patrikeder/SAdiy/zynq-ebaz/rtl/sim/vectors/README.md

# Golden vectors

Generated by `zynq-ebaz/rtl/sim/gen_vectors.py` (run `rtl/scripts/gen.sh`; never edit by hand). Plain text for
`$readmemh`: one hex value per line, fixed width, upper case, no `0x`. `gen_vectors.py --check` (and the pytest
`rtl/tests/test_gen_vectors.py`) fail when these files are not current.

| File | Lines | Width | Content |
|---|---|---|---|
| `spi_words.hex` | 101 | 8 digits | ADF4351 register words, `Adf4351.registers()` (write order R5..R0, all six) for 16 points 30..480 MHz (high-side LO, IF 10.7 MHz, PFD 25 MHz), main output on at -4 dBm; then the corner words `00000000`, `FFFFFFFF`, `AAAAAAAA`, `55555555`, `80000001` |
| `spi_words.cnt` | 1 | 8 digits | number of words in `spi_words.hex` |
| `mbb_high.hex` | 4096 | 5 digits | `{old[5:0], new[5:0], make[5:0]}` (18 bit), index `old*64+new`, PIN LEVEL masks (bit i = line i), PE4302 active high. `make` is the pin state the real `PE4302` driver shows after its turning-on writes and before its turning-off writes. Rule: `make = old | new` |
| `mbb_low.hex` | 4096 | 5 digits | the same for active low (a low pin switches the stage in). Rule: `make = old & new` |
| `sweep_table.hex` | 38 | 16 digits | table of the scenario below, `{w1, w0}` (64 bit, `w0` the SPI word, `w1` the flags of rtl-spec.md section 5) |
| `sweep_spi.hex` | 38 | 8 digits | SPI words the engine must send, in order |
| `sweep_result.hex` | 24 | 8 digits | result words the engine must store, in order |
| `sweep_unlock.hex` | 24 | 1 digit | per result index: `1` = the testbench's lock model must time out for that point, `0` = lock |
| `sweep_meta.hex` | 6 | 8 digits | n_entries, n_results, n_avg, det_base, att_pins, number of SPI words |

Scenario of `sweep_*`: produced by `PlModel` with `DET_CFG.src = 1`, `DET_TEST.base = 0x0100`,
`N_AVG = 4`, all timing registers at their reset values, `stop_on_err = 0`, `PE4302.manual` at its reset
value, `pin_owner = 1`. Table from `build_table()` for 24 points 50..450 MHz (IF 10.7 MHz, high-side
LO), `att_pins = 0x15` on the first entry, main output on at -4 dBm. Lock fails (timeout, result
bit 31 set) for result indices 5, 17; every other point locks. A result sum is `N_AVG * ((base + (index & 255)) & 0xFFFF)`.
