patrikeder/SAdiy/hw/netlist.md

# Netlist

Generated by `tools/gen_diagrams.py` from the pin map in `src/sadiy/pinmap.py`. Do not edit by hand.

BBB = BeagleBone Black headers P8 and P9. RPi = 40-pin header (physical pin numbers). Verify every pin on your image.

## SBC to board signals

| Net | Board | Board pin | Direction | BBB | RPi | Notes |
|---|---|---|---|---|---|---|
| SYN_CLK | ADF4351 | CLK | SBC to board | P9.22 SPI0_SCLK / GPIO0_2 | pin 23 GPIO11 / SPI0 SCLK | SPI mode 0, MSB first |
| SYN_DATA | ADF4351 | DAT | SBC to board | P9.18 SPI0_D1 (MOSI) / GPIO0_4 | pin 19 GPIO10 / SPI0 MOSI | 32-bit words |
| SYN_LE | ADF4351 | LE | SBC to board | P9.17 SPI0_CS0 / GPIO0_5 | pin 24 GPIO8 / SPI0 CE0 | SPI0 CS0, which is /dev/spidevN.0 (N = bus number, spi_device = 0); used as SPI chip select; data latches on the rising edge at the end of a transfer |
| SYN_LD | ADF4351 | LD | board to SBC | P9.23 GPIO1_17 | pin 35 GPIO19 / PCM_FS | digital lock detect output (Lock_Flag LED on the board), GPIO input; the MUX pin stays unused |
| SYN_CE | ADF4351 | CE | SBC to board | P9.27 GPIO3_19 | pin 36 GPIO16 | optional; tie the CE header pin to 3V3 until needed |
| ATT_V1 | PE4302 | V1 (0.5 dB) | SBC to board | P8.7 GPIO2_2 / TIMER4 | pin 29 GPIO5 | assumed weight; verify order and polarity with pe4302-walk |
| ATT_V2 | PE4302 | V2 (1 dB) | SBC to board | P8.8 GPIO2_3 / TIMER7 | pin 31 GPIO6 | assumed 1 dB stage |
| ATT_V3 | PE4302 | V3 (2 dB) | SBC to board | P8.9 GPIO2_5 / TIMER5 | pin 32 GPIO12 / PWM0 | assumed 2 dB stage |
| ATT_V4 | PE4302 | V4 (4 dB) | SBC to board | P8.10 GPIO2_4 / TIMER6 | pin 33 GPIO13 / PWM1 | assumed 4 dB stage |
| ATT_V5 | PE4302 | V5 (8 dB) | SBC to board | P8.11 GPIO1_13 / PRU0 R30_15 | pin 38 GPIO20 / PCM_DIN | assumed 8 dB stage |
| ATT_V6 | PE4302 | V6 (16 dB) | SBC to board | P8.12 GPIO1_12 / PRU0 R30_14 | pin 40 GPIO21 / PCM_DOUT | assumed 16 dB stage |
| DET_ADC | Detector | VOUT via divider | board to SBC | P9.39 AIN0 | n/a | BBB: AIN0 through the divider, a cross-check only (the ADS1115 is the main ADC); 0 to 1.8 V absolute maximum. RPi: ADS1115 only |
| ADC_GND | Detector | GND | return | P9.34 GNDA_ADC | n/a | optional, AIN0 cross-check only |
| I2C_SDA | ADS1115 | SDA | bidirectional | P9.20 I2C2_SDA / GPIO0_12 | pin 3 GPIO2 / SDA1 | main ADC on both platforms. BBB: I2C2 on the adapter board, which already has pull-ups (4.7k on the adapter not fitted) |
| I2C_SCL | ADS1115 | SCL | SBC to board | P9.19 I2C2_SCL / GPIO0_13 | pin 5 GPIO3 / SCL1 | main ADC on both platforms. BBB: I2C2 on the adapter board |

## Static straps on the boards (no SBC pin)

| Board | Pin | Tie to | Why |
|---|---|---|---|
| PE4302 | V1 ... V6 | module: 10k pull-downs | open inputs = 0 dB attenuation (the unsafe state). The adapter board's 2.2k pull-ups to 3V3 (R27..R32) give about 2.7 V at the pin, above the 2.3 V threshold, so the default is maximum attenuation; remove them for 0 dB |
| PE4302 | VDD pad | 3V3 (SBC pin) | the module has no regulator and is meant for 3.3 V (Silicon Chip). Two separate pads next to the chip, not on the 7-pin header (GND, V1 ... V6) |
| ADF4351 | DC jack | 5 V | on-board AMS1117-3.3 supplies the chip; check the polarity marking next to the jack. The 3V3 header pin is the regulator output: do not feed it |
| ADF4351 | CE | 3V3 | header pin, chip enable. Adapter board jumper J12: 1-2 tied high (default), 2-3 from the SBC pin (see SYN_CE) |
| ADF4351 | PDR | 3V3 | RF power-down pin (PDBRF): high = RF outputs on. Tied high on the adapter board (JP5); remove JP5 if the eval board already pulls it up |
| ADF4351 | AOUT- / AOUT+ | 50 ohm on the unused output | differential outputs, use one for the LO and terminate the other; MCLK is the external reference input (25 MHz oscillator fitted) |
| ADS1115 | A0 | detector VOUT via 1k, 100 nF, clamp | adapter board; no divider, the clamp holds A0 within 0 to 3.3 V |
| ADS1115 | ADDR | GND | I2C address 0x48 |
| ADS1115 | VDD | 3V3 (SBC pin) | 2.0 to 5.5 V |
| Detector | VCC pad | 5 V (verify) | about 68 mA at 5 V per the listing; the board has its own regulator (SOT-223), read its marking for the allowed input range |
| Detector | OUT header | check with a DMM | 2-pin header: find which pin is OUT and which is GND before connecting |

## Pins left free for later

- BBB: P9.11-P9.16, P8.13 to P8.19 and P8.26 (GPIO), SPI1 (P9.28-31), AIN1-AIN6, UART1 (P9.24/26).
- RPi: SPI0 CE1 (pin 26), GPIO 17/27/22/23/24/25, UART (pins 8/10).

## Ground and supply pins

- BBB: GND P9.1, P9.2, P9.43-46 and P8.1, P8.2; GNDA_ADC P9.34 (optional, AIN0 cross-check only); ADC reference VDD_ADC P9.32 (1.8 V, do not load).
- RPi: GND pins 6, 9, 14, 20, 25, 30, 34, 39.
- Board supplies come from the power tree, not from SBC pins (`power-tree.svg`).
