patrikeder/SAdiy/zynq-ebaz/docs/pinmap.md

# Pin map (generated by rtl/scripts/gen_pinmap.py, do not edit)

Reference: EBAZ4205 (XC7Z010-CLG400), expansion connectors DATA1..3 (2.0 mm, 2x10). All I/O LVCMOS33, series 22 ohm on the board. Master list: `rtl/vivado/pins.toml` (session L). "In use" = constrained in the current bitstream.

## Expansion connectors

| Connector pin | FPGA ball | Bank | I/O name | Signal | Dir | Function | Status | EMIO / note |
|---|---|---|---|---|---|---|---|---|
| DATA1-5 | A20 | 35 | IO_L2N_T0_AD8N_35 | `adc_d[0]` | in | AD9226 (planned) | planned |  |
| DATA1-6 | H16 | 35 | IO_L13P_T2_MRCC_35 | `adc_otr` | in | AD9226 (planned) | planned |  |
| DATA1-7 | B19 | 35 | IO_L2P_T0_AD8P_35 | `adc_d[1]` | in | AD9226 (planned) | planned |  |
| DATA1-8 | B20 | 35 | IO_L1N_T0_AD0N_35 | `adc_d[2]` | in | AD9226 (planned) | planned |  |
| DATA1-9 | C20 | 35 | IO_L1P_T0_AD0P_35 | `adc_d[3]` | in | AD9226 (planned) | planned |  |
| DATA1-11 | H17 | 35 | IO_L13N_T2_MRCC_35 | `adc_d[11]` | in | AD9226 (planned) | planned |  |
| DATA1-13 | D20 | 35 | IO_L4N_T0_35 | `adc_d[4]` | in | AD9226 (planned) | planned | schematic text says D19, see header |
| DATA1-14 | D18 | 35 | IO_L3N_T0_DQS_AD1N_35 | `adc_d[5]` | in | AD9226 (planned) | planned |  |
| DATA1-15 | H18 | 35 | IO_L14N_T2_AD4N_SRCC_35 | `adc_d[10]` | in | AD9226 (planned) | planned |  |
| DATA1-16 | D19 | 35 | IO_L4P_T0_35 | `adc_d[6]` | in | AD9226 (planned) | planned |  |
| DATA1-17 | F20 | 35 | IO_L15N_T2_DQS_AD12N_35 | `adc_d[7]` | in | AD9226 (planned) | planned |  |
| DATA1-18 | E19 | 35 | IO_L5N_T0_AD9N_35 | `adc_d[8]` | in | AD9226 (planned) | planned |  |
| DATA1-19 | F19 | 35 | IO_L15P_T2_DQS_AD12P_35 | `adc_d[9]` | in | AD9226 (planned) | planned |  |
| DATA1-20 | K17 | 35 | IO_L12P_T1_MRCC_35 | `adc_clk` | out | AD9226 (planned) | planned |  |
| DATA2-5 | G20 | 35 | IO_L18N_T2_AD13N_35 | `adf4351_clk` | out | ADF4351 synthesiser | in use | PS SPI0 SCLK via EMIO |
| DATA2-6 | J18 | 35 | IO_L14P_T2_AD4P_SRCC_35 | `spare_d2_6` | inout | spare | planned | spare |
| DATA2-7 | G19 | 35 | IO_L18P_T2_AD13P_35 | `adf4351_dat` | out | ADF4351 synthesiser | in use | PS SPI0 MOSI via EMIO |
| DATA2-8 | H20 | 35 | IO_L17N_T2_AD5N_35 | `adf4351_le` | out | ADF4351 synthesiser | in use | PS SPI0 SS0 via EMIO (LE = chip select) |
| DATA2-9 | J19 | 35 | IO_L10N_T1_AD11N_35 | `adf4351_ld` | in | ADF4351 synthesiser | in use | lock detect, EMIO GPIO input; pulldown so a missing cable reads unlocked |
| DATA2-11 | K18 | 35 | IO_L12N_T1_MRCC_35 | `i2c_sda` | inout | I2C, ADS1115 | in use | PS I2C0 SDA via EMIO |
| DATA2-13 | K19 | 35 | IO_L10P_T1_AD11P_35 | `adf4351_ce` | out | ADF4351 synthesiser | in use | EMIO GPIO, tri-stated until software drives it; adapter jumper holds CE high |
| DATA2-14 | J20 | 35 | IO_L17P_T2_AD5P_35 | `pe4302_v[0]` | out | PE4302 attenuator | in use | V1 = 0.5 dB |
| DATA2-15 | L16 | 35 | IO_L11P_T1_SRCC_35 | `pe4302_v[1]` | out | PE4302 attenuator | in use | V2 = 1 dB |
| DATA2-16 | L19 | 35 | IO_L9P_T1_DQS_AD3P_35 | `pe4302_v[2]` | out | PE4302 attenuator | in use | V3 = 2 dB |
| DATA2-17 | M18 | 35 | IO_L8N_T1_AD10N_35 | `pe4302_v[3]` | out | PE4302 attenuator | in use | V4 = 4 dB |
| DATA2-18 | L20 | 35 | IO_L9N_T1_DQS_AD3N_35 | `pe4302_v[4]` | out | PE4302 attenuator | in use | V5 = 8 dB |
| DATA2-19 | M20 | 35 | IO_L7N_T1_AD2N_35 | `pe4302_v[5]` | out | PE4302 attenuator | in use | V6 = 16 dB |
| DATA2-20 | L17 | 35 | IO_L11N_T1_SRCC_35 | `i2c_scl` | inout | I2C, ADS1115 | in use | PS I2C0 SCL via EMIO (ADS1115, address 0x48) |

Supply / ground per the plan: pins 1-2 of every connector are supply (5..12 V, never wire to a peripheral), 3-4 and 12 GND, 10 NC. DATA3 is not mapped yet.

## Board-fixed pins, one line each

| FPGA ball / pin | Bank | I/O name | Signal | Group |
|---|---|---|---|---|
| G17 | 35 | IO_L16P_T2_35 | `ENET0_GMII_RX_ER_0` | Ethernet PHY (MII on EMIO) |
| U14 | 34 | IO_L11P_T1_SRCC_34 | `ENET0_GMII_RX_CLK_0` | Ethernet PHY (MII on EMIO) |
| U15 | 34 | IO_L11N_T1_SRCC_34 | `ENET0_GMII_TX_CLK_0` | Ethernet PHY (MII on EMIO) |
| U18 | 34 | IO_L12P_T1_MRCC_34 | `enet0_phy_clk` | Ethernet PHY (MII on EMIO) |
| V16 | 34 | IO_L18P_T2_34 | `ENET0_GMII_RXD_P[1]` | Ethernet PHY (MII on EMIO) |
| V17 | 34 | IO_L21P_T3_DQS_34 | `ENET0_GMII_RXD_P[2]` | Ethernet PHY (MII on EMIO) |
| V18 | 34 | IO_L21N_T3_DQS_34 | `ENET0_GMII_TXD_P[2]` | Ethernet PHY (MII on EMIO) |
| W15 | 34 | IO_L10N_T1_34 | `enet0_mdio_mdc` | Ethernet PHY (MII on EMIO) |
| W16 | 34 | IO_L18N_T2_34 | `ENET0_GMII_RX_DV_0` | Ethernet PHY (MII on EMIO) |
| W18 | 34 | IO_L22P_T3_34 | `ENET0_GMII_TXD_P[0]` | Ethernet PHY (MII on EMIO) |
| W19 | 34 | IO_L22N_T3_34 | `ENET0_GMII_TX_EN_0[0]` | Ethernet PHY (MII on EMIO) |
| Y14 | 34 | IO_L8N_T1_34 | `enet0_mdio_mdio_io` | Ethernet PHY (MII on EMIO) |
| Y16 | 34 | IO_L7P_T1_34 | `ENET0_GMII_RXD_P[0]` | Ethernet PHY (MII on EMIO) |
| Y17 | 34 | IO_L7N_T1_34 | `ENET0_GMII_RXD_P[3]` | Ethernet PHY (MII on EMIO) |
| Y18 | 34 | IO_L17P_T2_34 | `ENET0_GMII_TXD_P[1]` | Ethernet PHY (MII on EMIO) |
| Y19 | 34 | IO_L17N_T2_34 | `ENET0_GMII_TXD_P[3]` | Ethernet PHY (MII on EMIO) |
| A16 | 501 | PS_MIO24_501 | MIO 24 | UART1 TX/RX (console, J7) |
| F15 | 501 | PS_MIO25_501 | MIO 25 | UART1 TX/RX (console, J7) |
| D14 | 501 | PS_MIO40_501 | MIO 40 | SD0 (boot card) |
| C17 | 501 | PS_MIO41_501 | MIO 41 | SD0 (boot card) |
| E12 | 501 | PS_MIO42_501 | MIO 42 | SD0 (boot card) |
| A9 | 501 | PS_MIO43_501 | MIO 43 | SD0 (boot card) |
| F13 | 501 | PS_MIO44_501 | MIO 44 | SD0 (boot card) |
| B15 | 501 | PS_MIO45_501 | MIO 45 | SD0 (boot card) |

Bank 34 and 35 are the PL I/O banks (3.3 V here); banks 500 and 501 are the PS MIO banks. Package ball map: `pinmap-fpga.svg`.

## EMIO line map (Linux GPIO line = 54 + n on the Zynq gpiochip)

| n | Signal | n | Signal |
|---|---|---|---|
| 0 | pe4302_v[0] (V1) | 8 | unused |
| 1 | pe4302_v[1] (V2) | 9 | unused |
| 2 | pe4302_v[2] (V3) | 10 | unused |
| 3 | pe4302_v[3] (V4) | 11 | unused |
| 4 | pe4302_v[4] (V5) | 12 | unused |
| 5 | pe4302_v[5] (V6) | 13 | unused |
| 6 | adf4351_ce | 14 | unused |
| 7 | adf4351_ld | 15 | unused |

Also on EMIO: SPI0 (SCLK, MOSI, SS0 = LE) and I2C0 (SCL, SDA), see the table above.
