patrikeder/SAdiy/hw/boards/ad831.md

# AD831 mixer board

| Item | Value |
|---|---|
| Part | AD831, doubly balanced active mixer |
| RF / LO bandwidth | to 500 MHz (RF IP3 spec'd to 400 MHz) |
| IF output | to 250 MHz differential current, or DC to over 200 MHz single-ended voltage |
| LO drive | -10 dBm |
| Performance | IP3 +24 dBm, P1dB +10 dBm, NF 10.3 dB @ 70 MHz, 14 dB @ 150 MHz |
| Supply (chip) | +/-4.5 to +/-5.5 V, or 9 to 11 V single; 100 to 125 mA |
| Common module | 33 x 33 mm, single 9 to 11 V supply, DC-isolation capacitors on RF / IF / LO, IF gain set by a resistor between OUT and VFB |

## Seen in the photo ([photos/ad831-module.jpg](../photos/ad831-module.jpg))
Silkscreen `AD831_MIX Freq:1-500MHz`. SMA `RFin` (one end), `LOin` (side), `IFout` (opposite end of RFin); two pads `GND` and `VCC` with grey leads soldered on. So it is the single-supply module (datasheet single supply: 9 to 11 V), not a bare chip. The supply voltage actually applied is not visible: measure it.

Fill in from the PCB
- Is this the common single-supply module or a custom board: TODO
- Supply connector, voltage actually used, measured current: TODO
- RF / LO / IF connectors (type, labels): TODO
- IF gain resistor value (OUT to VFB) and resulting conversion gain: TODO
- Which ports are AC-coupled, and the coupling capacitor values (low-frequency limit for the 10.7 MHz IF): TODO
- Test points available: TODO

The IF output needs a 10.7 MHz filter and gain before the detector (`../todo-parts.md`). LO should be about -10 dBm and low-pass filtered.
