patrikeder/SAdiy/hw/boards/adf4351.md

# ADF4351 synthesizer board (LO)

Photo: [photos/adf4351-board.jpg](../photos/adf4351-board.jpg). Silkscreen: `ADF4351X EVAL Board 2019_1_v1.4`.

## What the photo shows
- Reference: on-board oscillator marked `V25.000 KDSH 4D`, so the reference is **25 MHz**. An SMA `MCLK` input is next to it for an external reference.
- Outputs: two SMA connectors, `AOUT-` and `AOUT+` (the differential RF outputs). Both have cables fitted.
- Power: a DC barrel jack labelled **5 V** (with a polarity symbol and a red LED) and an `AMS1117 3.3` regulator on the board. The chip is supplied from the on-board 3.3 V.
- 2 x 5 pin header, left column `GND CE LE CLK LD`, right column `3V3 GND DAT MUX PDR` (rows from the top: GND/3V3, CE/GND, LE/DAT, CLK/MUX, LD/PDR).
- Silkscreen `Lock_Flag` next to an LED: lock detect indicator.

## Facts

| Item | Value |
|---|---|
| Part | ADF4351, 35 to 4400 MHz, 25 MHz PFD with this reference |
| Supply | 5 V on the DC jack; AMS1117-3.3 on the board. The `3V3` header pin is the regulator output: **do not feed it** |
| Logic | 3.3 V, SPI mode 0, MSB first, 32-bit words; `LE` latches on the rising edge |
| Header | `CLK`, `DAT`, `LE` = SPI; `LD` = lock detect output (use this); `MUX` = MUXOUT (unused); `CE` = chip enable; `PDR` = RF power-down pin (PDBRF), high = RF outputs on |
| RF output | -4 to +5 dBm in 3 dB steps; harmonics only 10 to 20 dB down (low-pass filter needed behind it) |

Use one output for the LO and terminate the other in 50 ohm (the outputs are complementary).

## RF outputs: off by default
- Software: both RF outputs are off after `Adf4351(...)` is constructed (it writes an R4 word with both disabled before anything else). An output is on only after `enable_output("main")` / `set_outputs(...)`, which should happen after the PLL is programmed and locked. `config/default.toml` enables only `out_main_enable`; a missing key means off.
- `AOUT+` and `AOUT-` are presumably the two halves of RFOUTA (the main output), so software cannot switch one of them off: whichever is not cabled to the mixer still needs the 50 ohm termination. The aux output (RFOUTB) is disabled in R4; check on the board schematic whether it is brought out at all.
- Hardware: the board's `PDR` pin (RF power-down) is currently to be tied high (see below). If the outputs should also stay off while the SBC is not running, drive `PDR` from an SBC pin with a pull-down instead. Not done, because it changes the adapter schematic and the wiring pages.

## Control from the SBC
- `CLK`, `DAT`, `LE` to the SPI0 pins (`../wiring-bbb.md`, `../wiring-rpi.md`), `LD` to a GPIO input, `GND` to the star point.
- `CE` and `PDR` must be high: tie them to the board's `3V3` pin, or keep CE on an SBC pin (`SYN_CE`). Measure first whether the board already pulls them up.
- The 25 MHz reference matches `synth.ref_hz` and `synth.pfd_hz` in `config/default.toml`.
- Driver: `src/sadiy/drivers/adf4351.py` (R4 with the output enables is done; R0..R3 and R5 packing still to be written).

## Still to check
- Polarity marking next to the DC jack before connecting the 5 V rail.
- Which SMA (`AOUT+` or `AOUT-`) is cabled to the mixer LO input and what the other one is terminated with.
- The loop filter on this board (affects lock time); measure the lock time before tightening `sweep.settle_s`.
- Current from 5 V (the linear regulator drops 1.7 V, so about 0.2 A of load is about 0.3 W of heat in the AMS1117).
