patrikeder/SAdiy/hw/boards/sbc.md

# SBC (BeagleBone Black preferred, Raspberry Pi 3/4/400 supported)

| Item | BBB | RPi |
|---|---|---|
| Supply | 5 V / 2 A | 5.1 V / 3 A (RPi 4 / 400) |
| GPIO / SPI level | 3.3 V | 3.3 V |
| Analog input | 8 channels, 12-bit, **0 to 1.8 V max** (verify on your image) | none: external ADC |
| Display | remote viewer over network | local monitor or remote |
| Image / OS version | TODO | TODO |
| python3 version | TODO (code supports 3.9+) | TODO |

Fill in
- Which board is actually used for the first build: TODO
- Header or breakout used to reach the boards: TODO
- Ground star point location: TODO

Pin map: `../wiring.md`. Setup notes: `../../deploy/bbb-setup.md`.
