patrikeder/SAdiy/hw/boards/sbc-adapter/placement.png

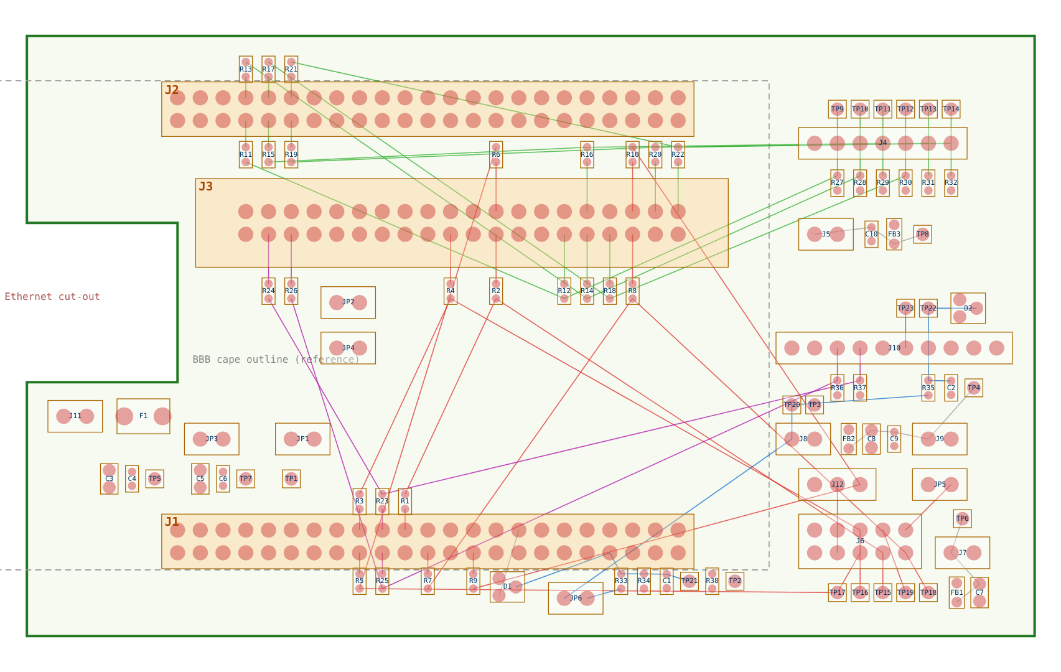
hw/boards/sbc-adapter/placement.png
