patrikeder/SAdiy/hw/boards/sbc-adapter/preview.png

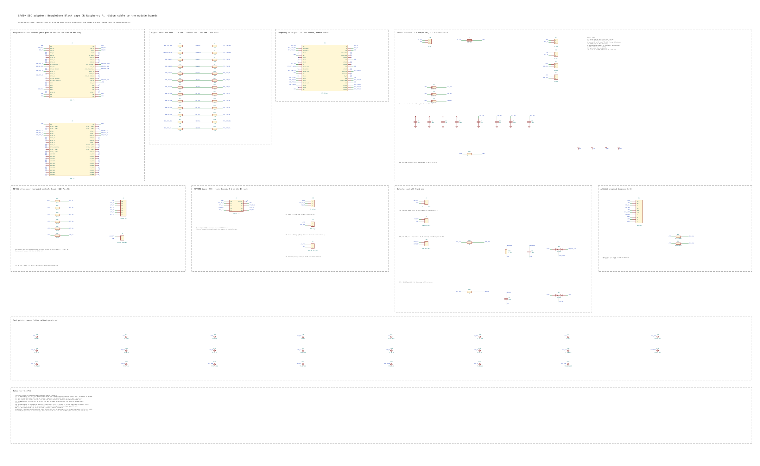
hw/boards/sbc-adapter/preview.png
