patrikeder/SAdiy/hw/boards/sbc-adapter/routability/heat.png

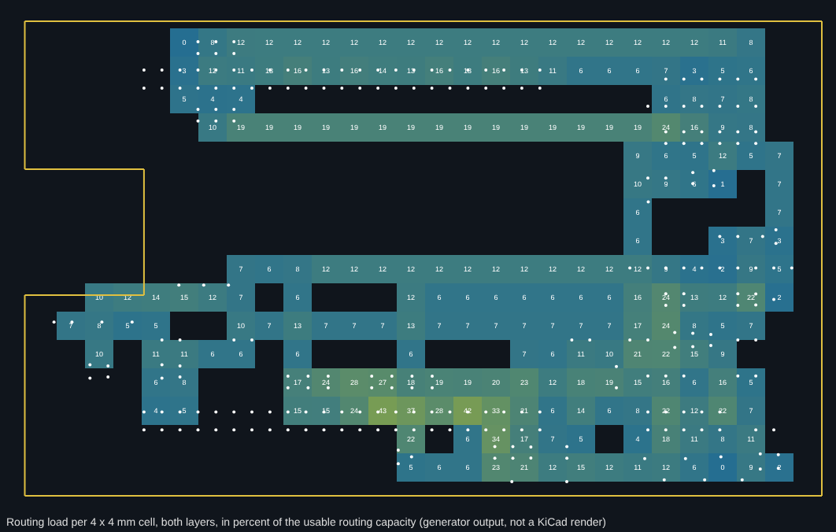
hw/boards/sbc-adapter/routability/heat.png
