patrikeder/SAdiy/hw/boards/sbc-adapter/routability/routed.png

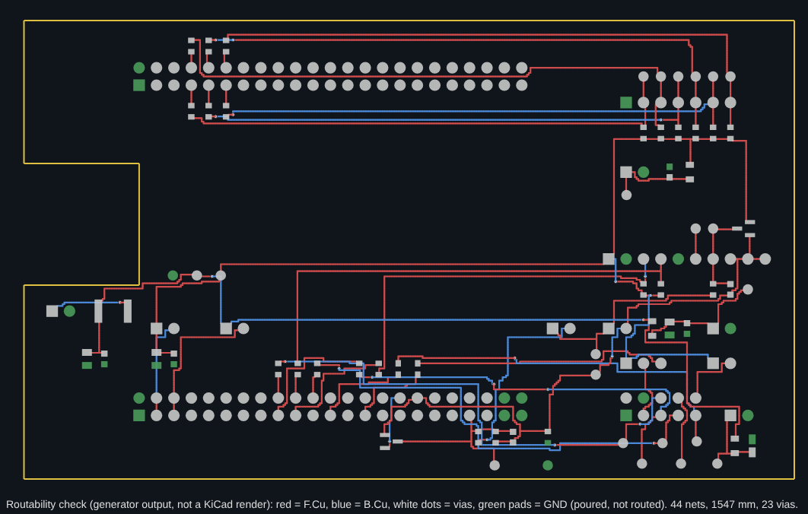
hw/boards/sbc-adapter/routability/routed.png
