patrikeder/SAdiy/hw/photos/ad831-module.jpg

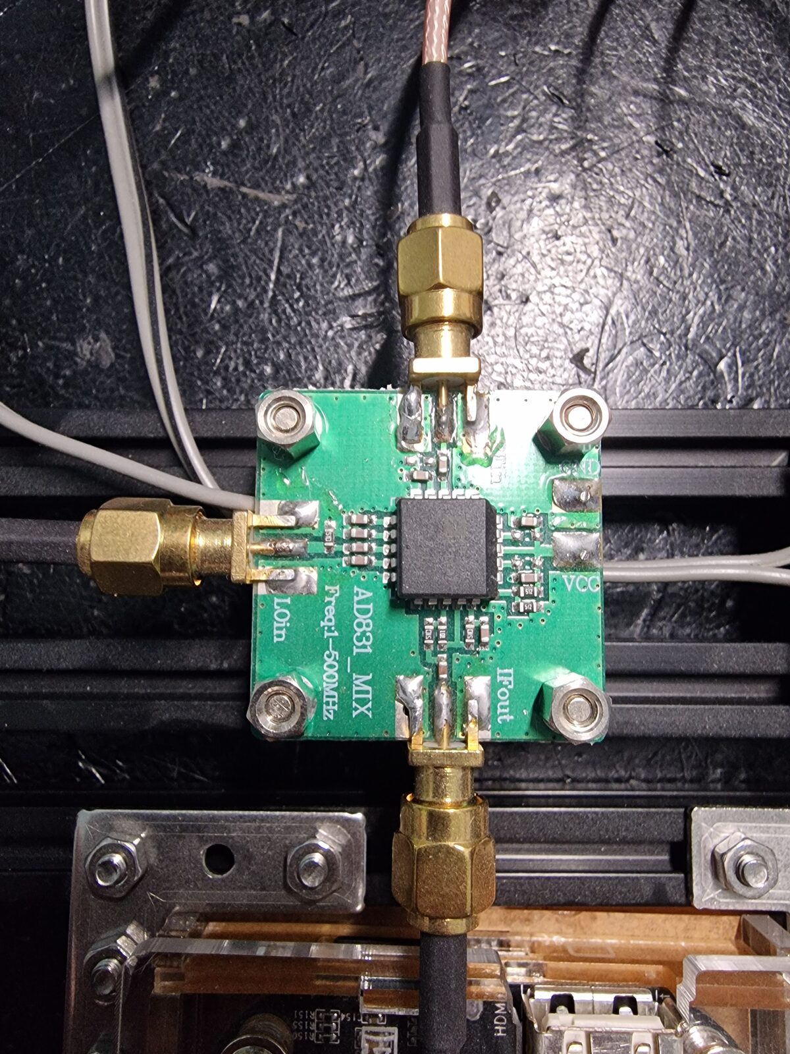
hw/photos/ad831-module.jpg
