patrikeder/SAdiy/hw/photos/adf4351-board.jpg

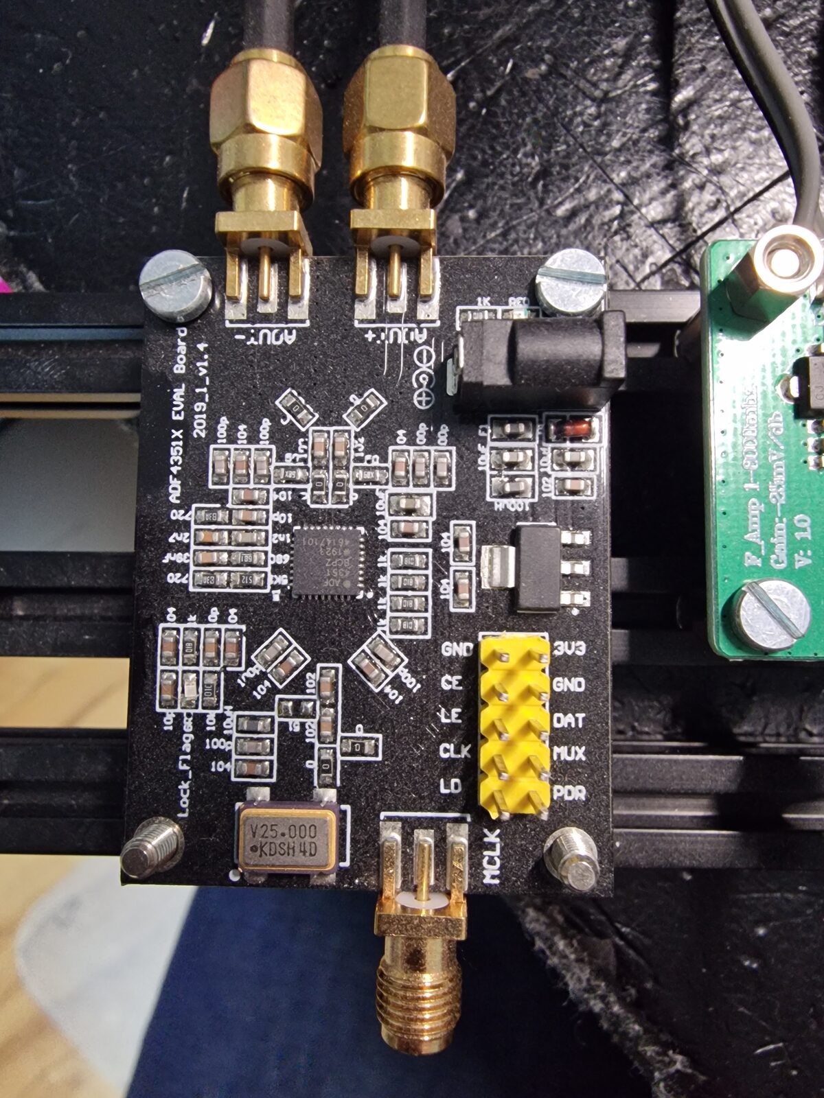
hw/photos/adf4351-board.jpg
