patrikeder/SAdiy/hw/photos/detector-module.jpg

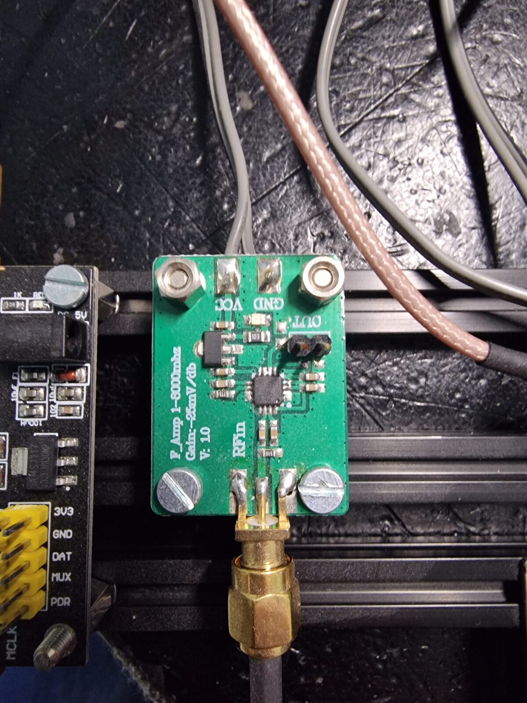
hw/photos/detector-module.jpg
