patrikeder/SAdiy/hw/photos/pe4302-module.jpg

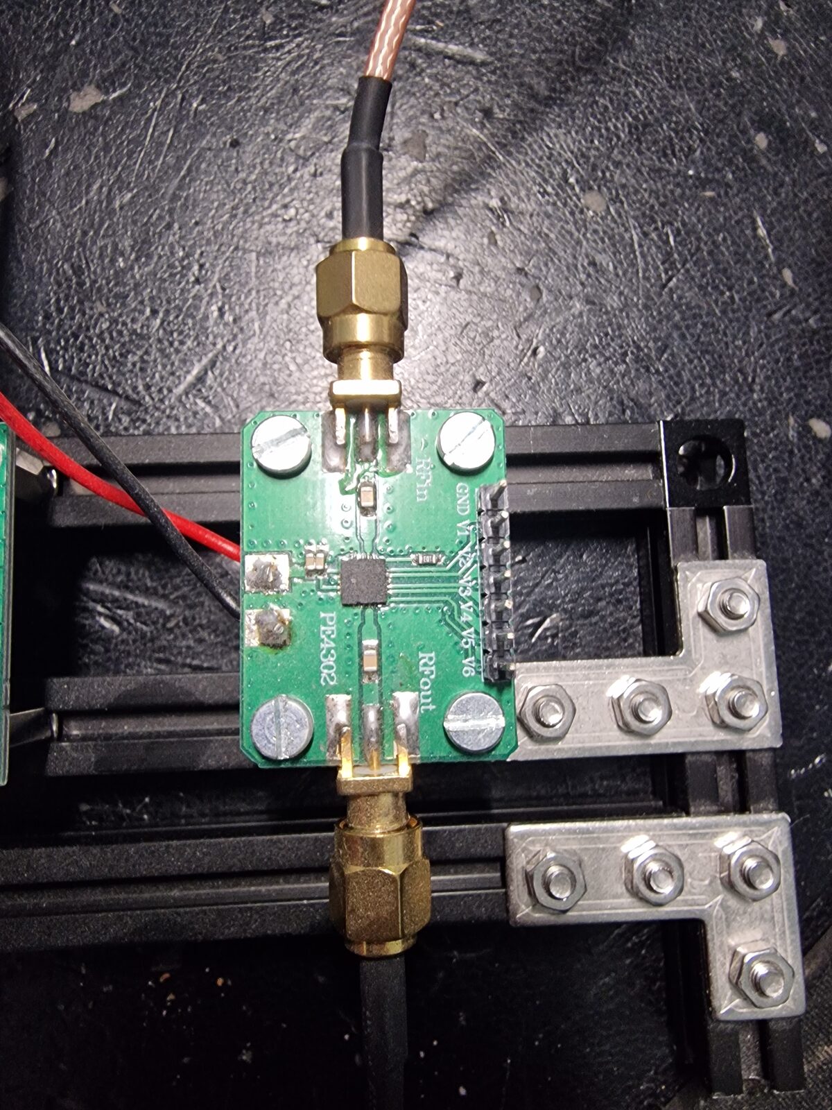
hw/photos/pe4302-module.jpg
