patrikeder/SAdiy/hw/boards/sbc-adapter/sa_sbc_adapter.kicad_pcb

## KiCad design hw/boards/sbc-adapter/sa_sbc_adapter.kicad_pcb (2026-11-05)

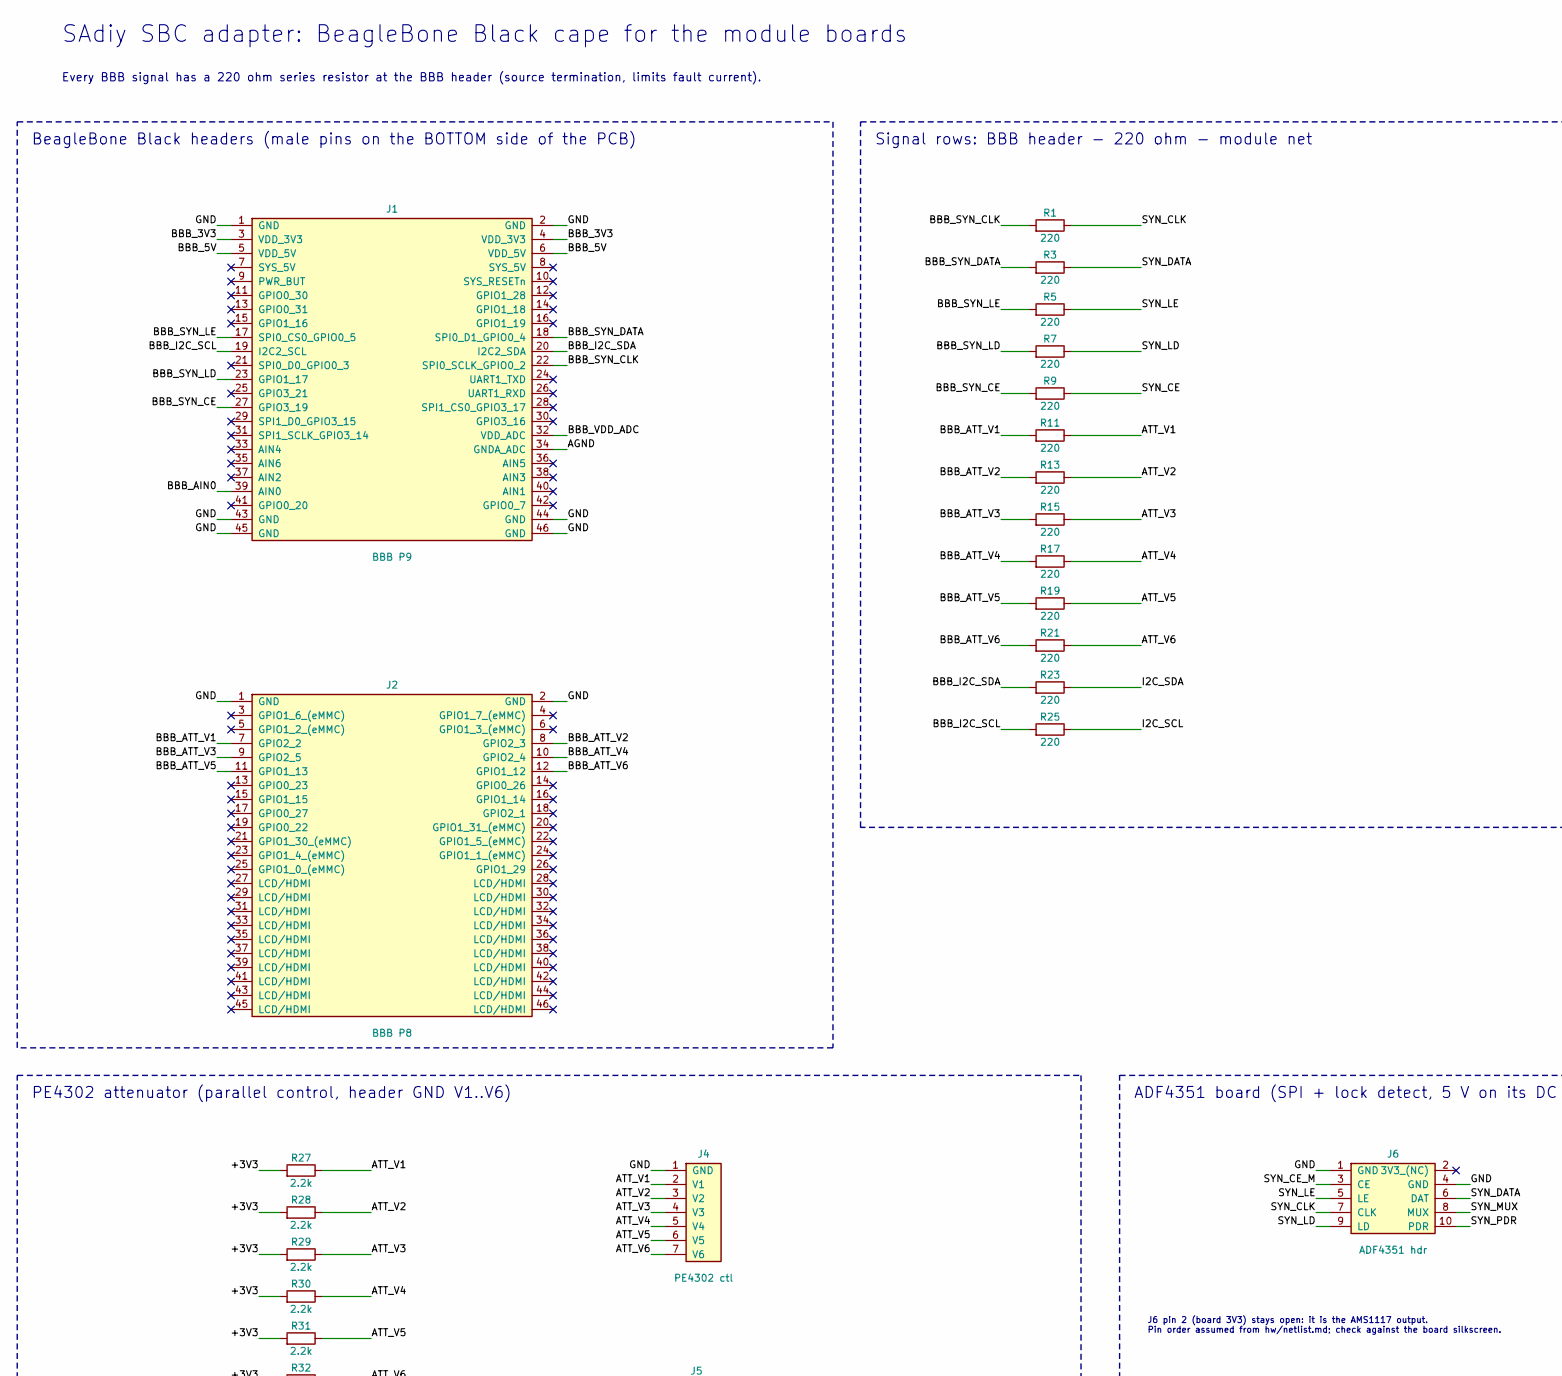
[picture p18: schematic sa_sbc_adapter.kicad_sch, SAdiy SBC adapter, part in row 1, column 1]

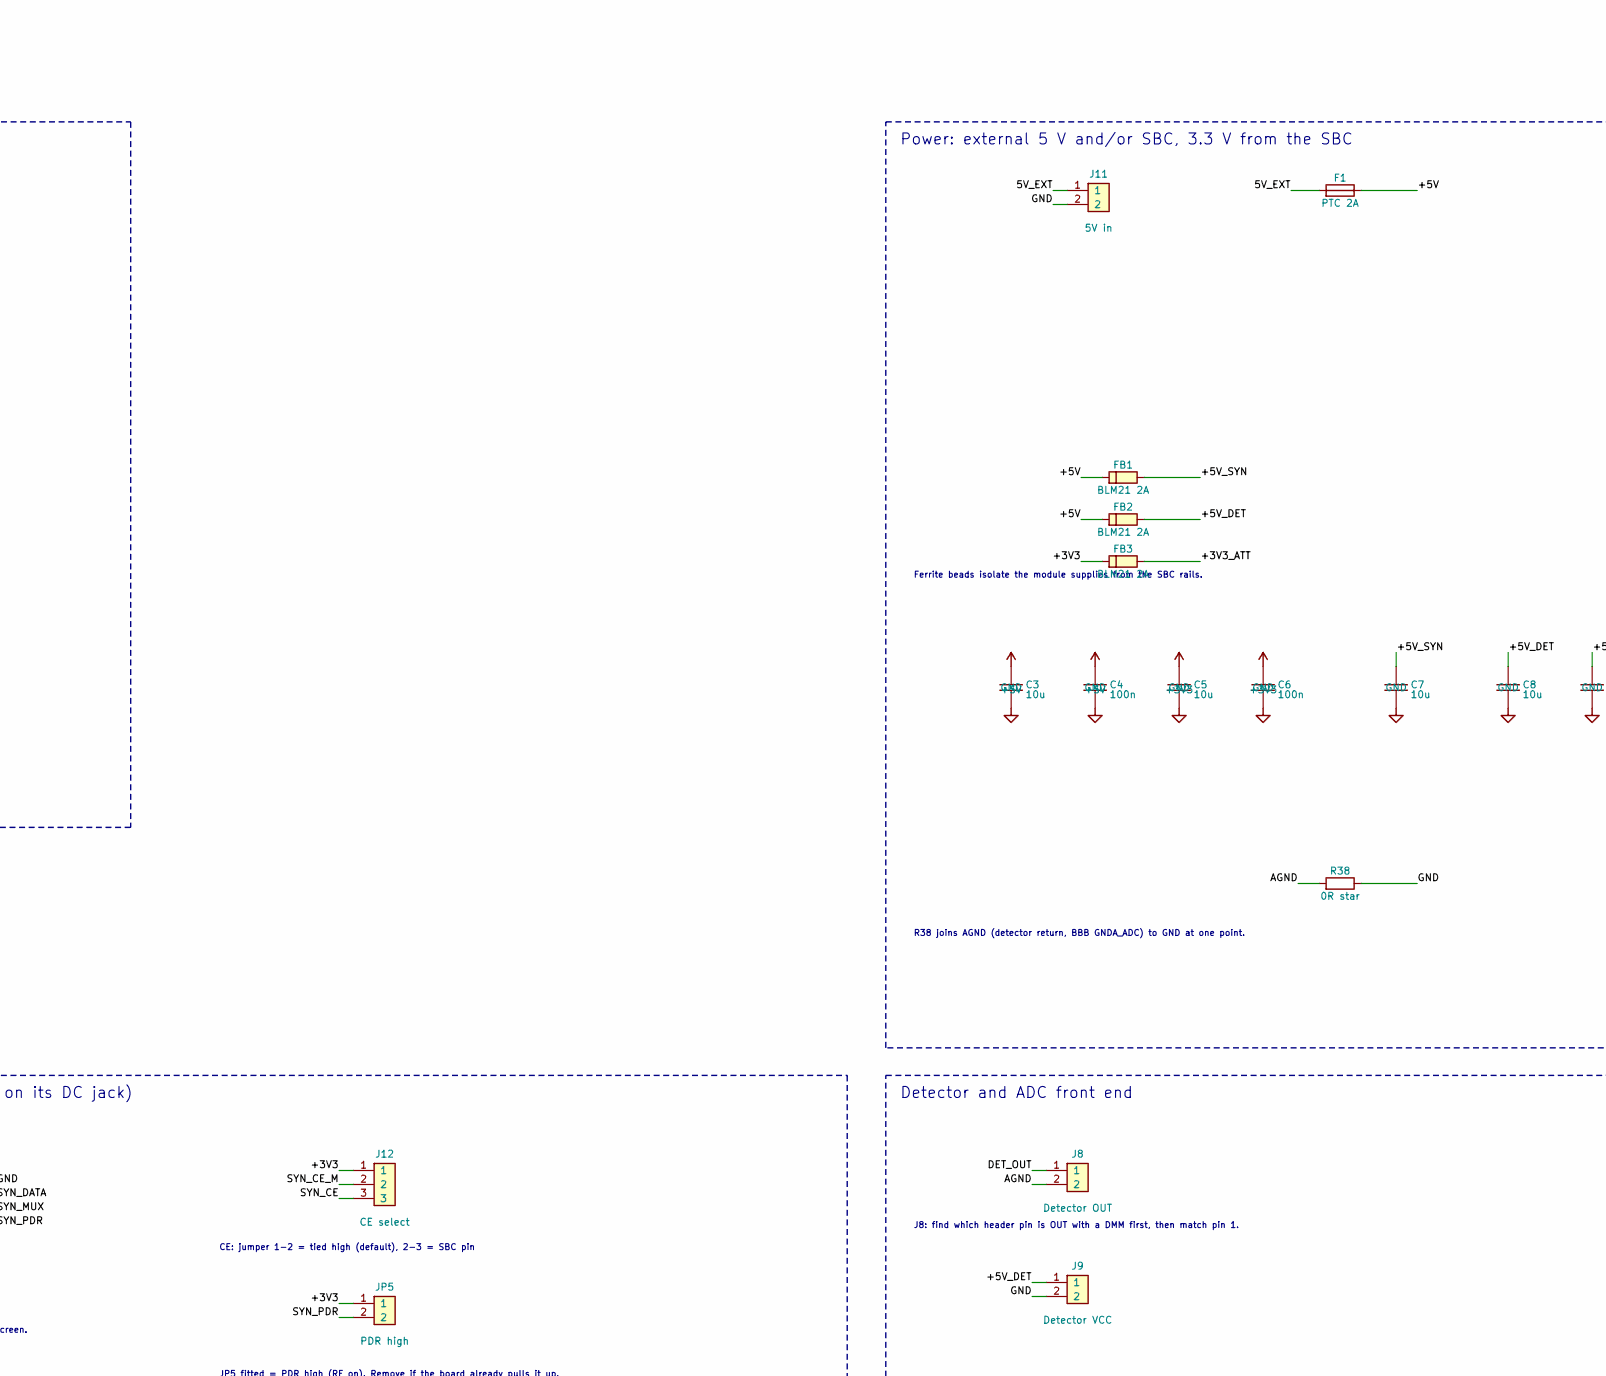
[picture p19: schematic sa_sbc_adapter.kicad_sch, SAdiy SBC adapter, part in row 1, column 2]

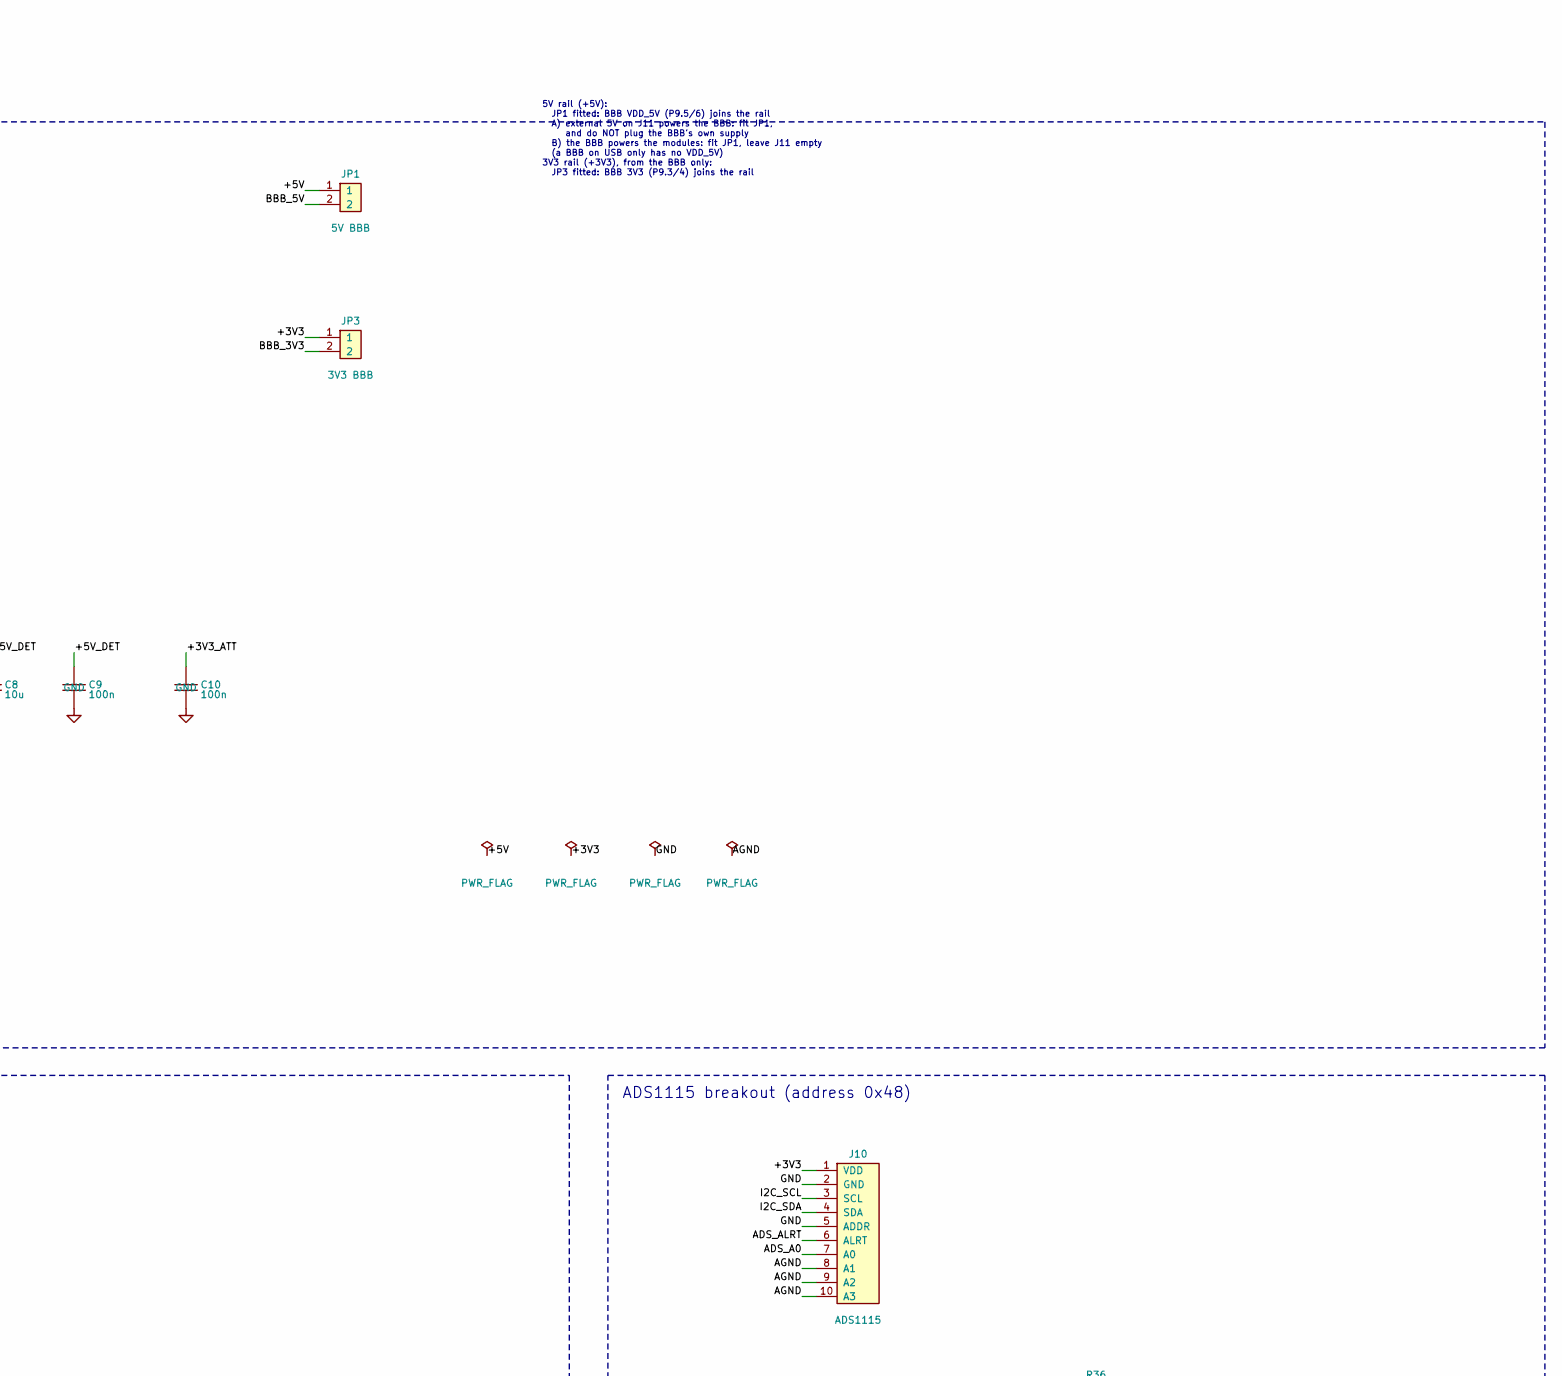
[picture p20: schematic sa_sbc_adapter.kicad_sch, SAdiy SBC adapter, part in row 1, column 3]

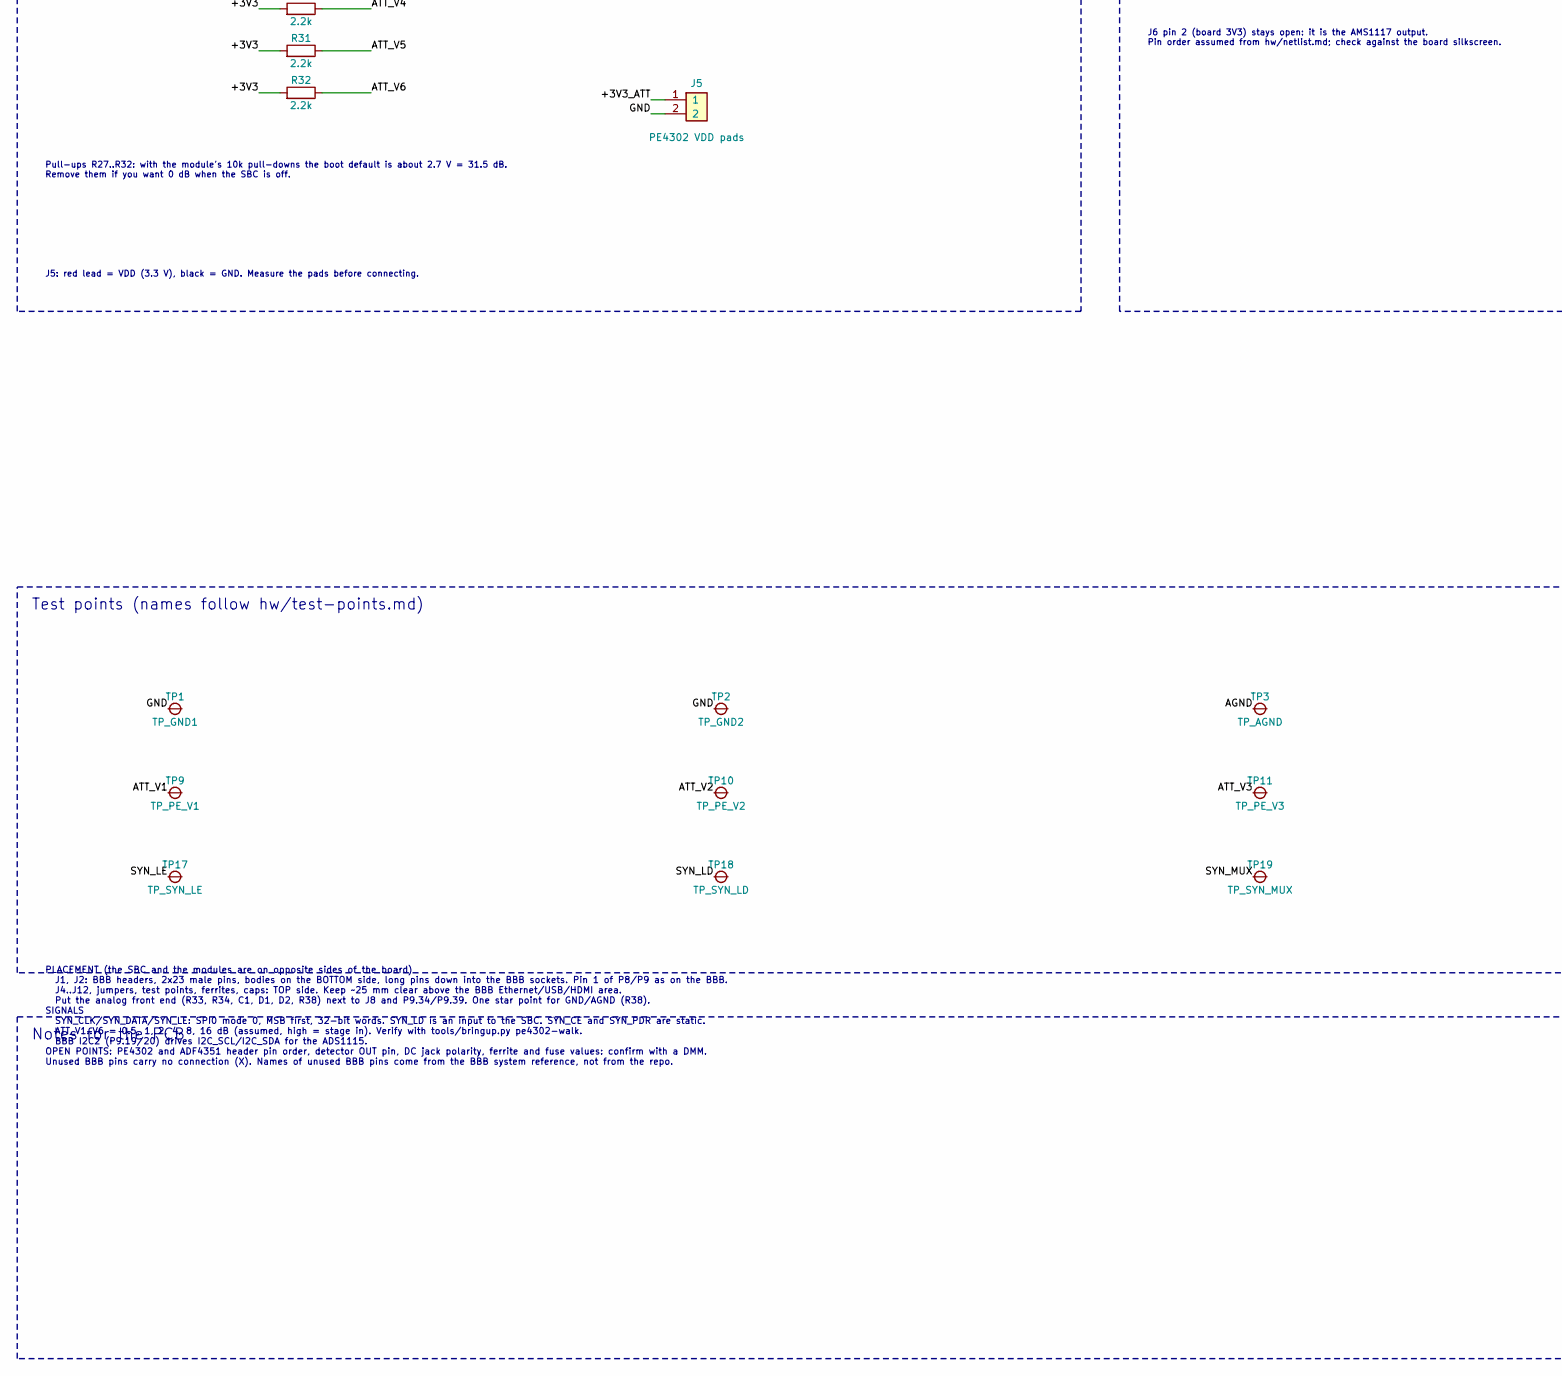
[picture p21: schematic sa_sbc_adapter.kicad_sch, SAdiy SBC adapter, part in row 2, column 1]

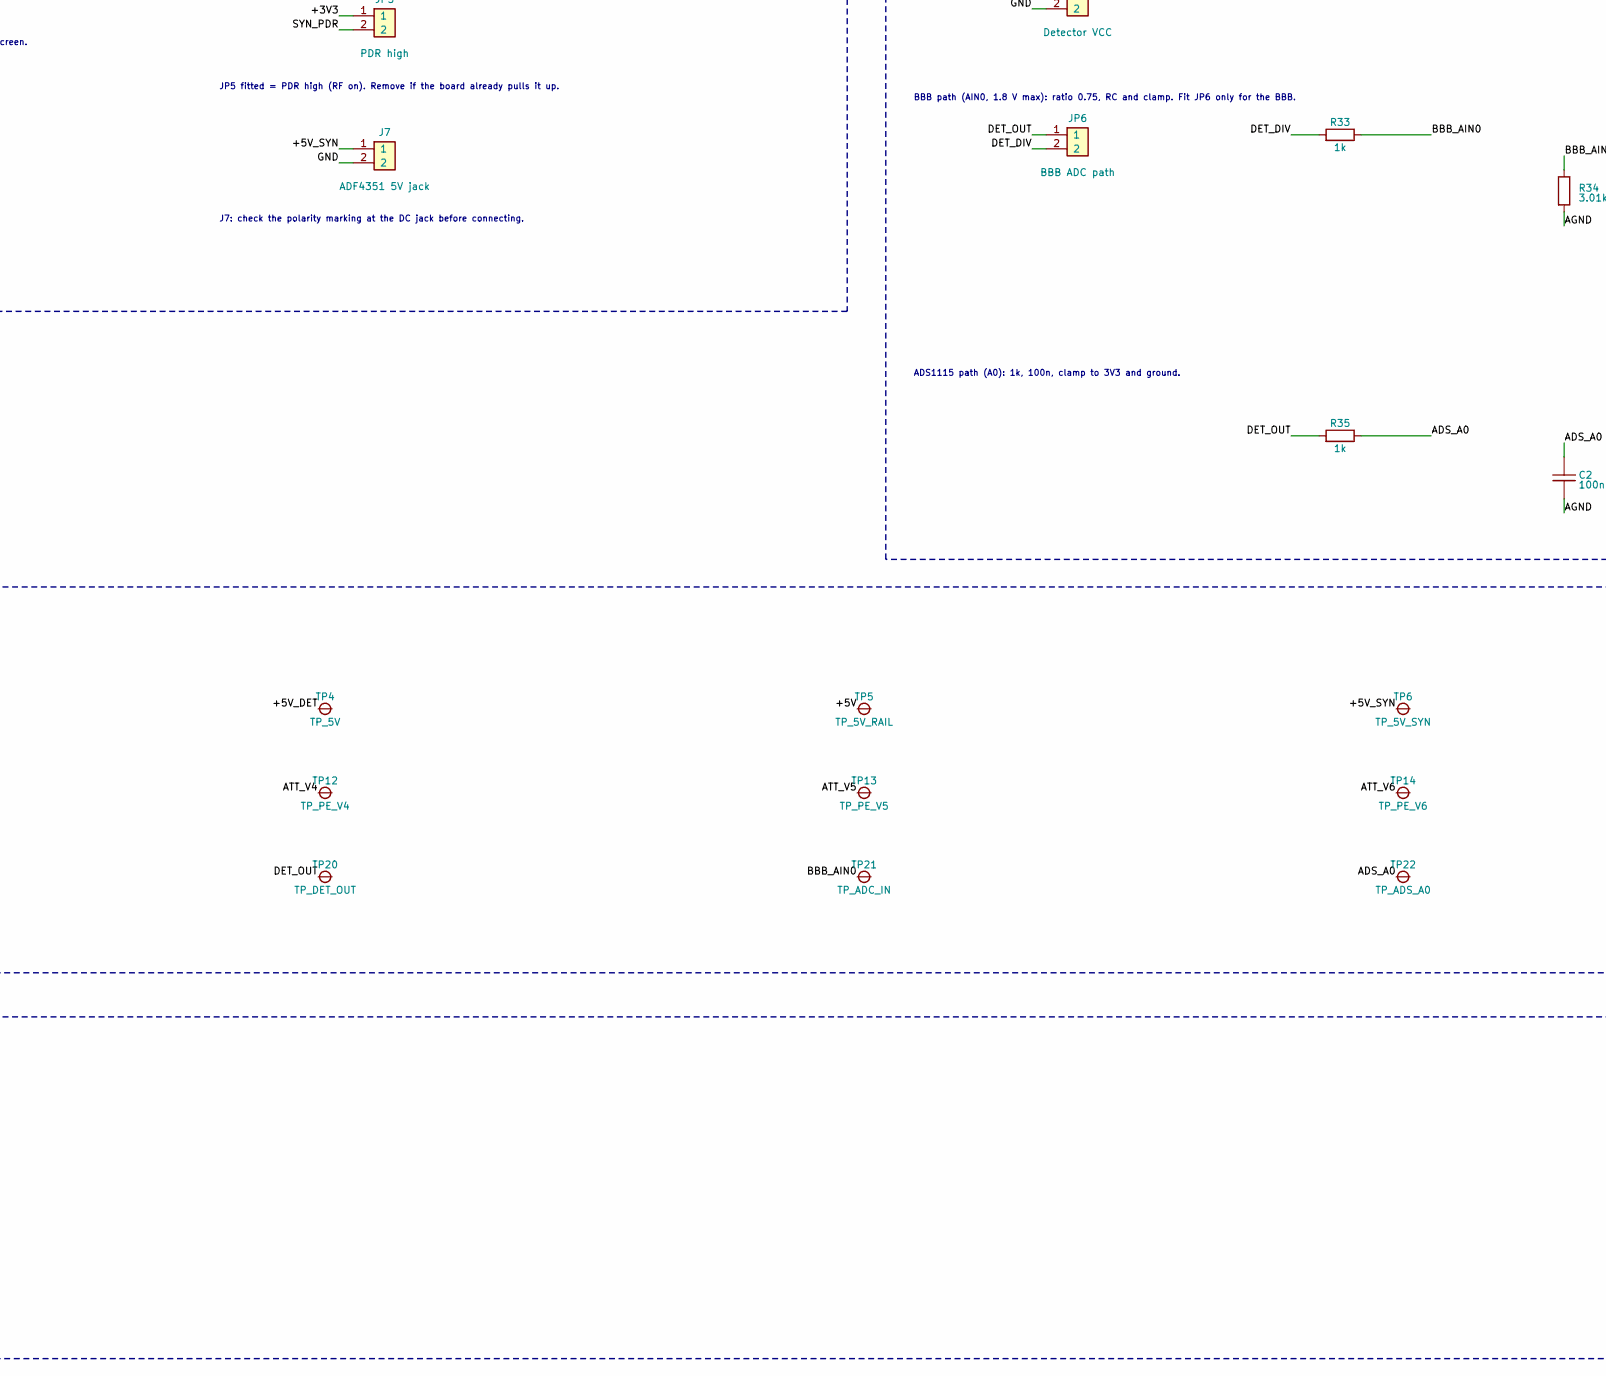
[picture p22: schematic sa_sbc_adapter.kicad_sch, SAdiy SBC adapter, part in row 2, column 2]

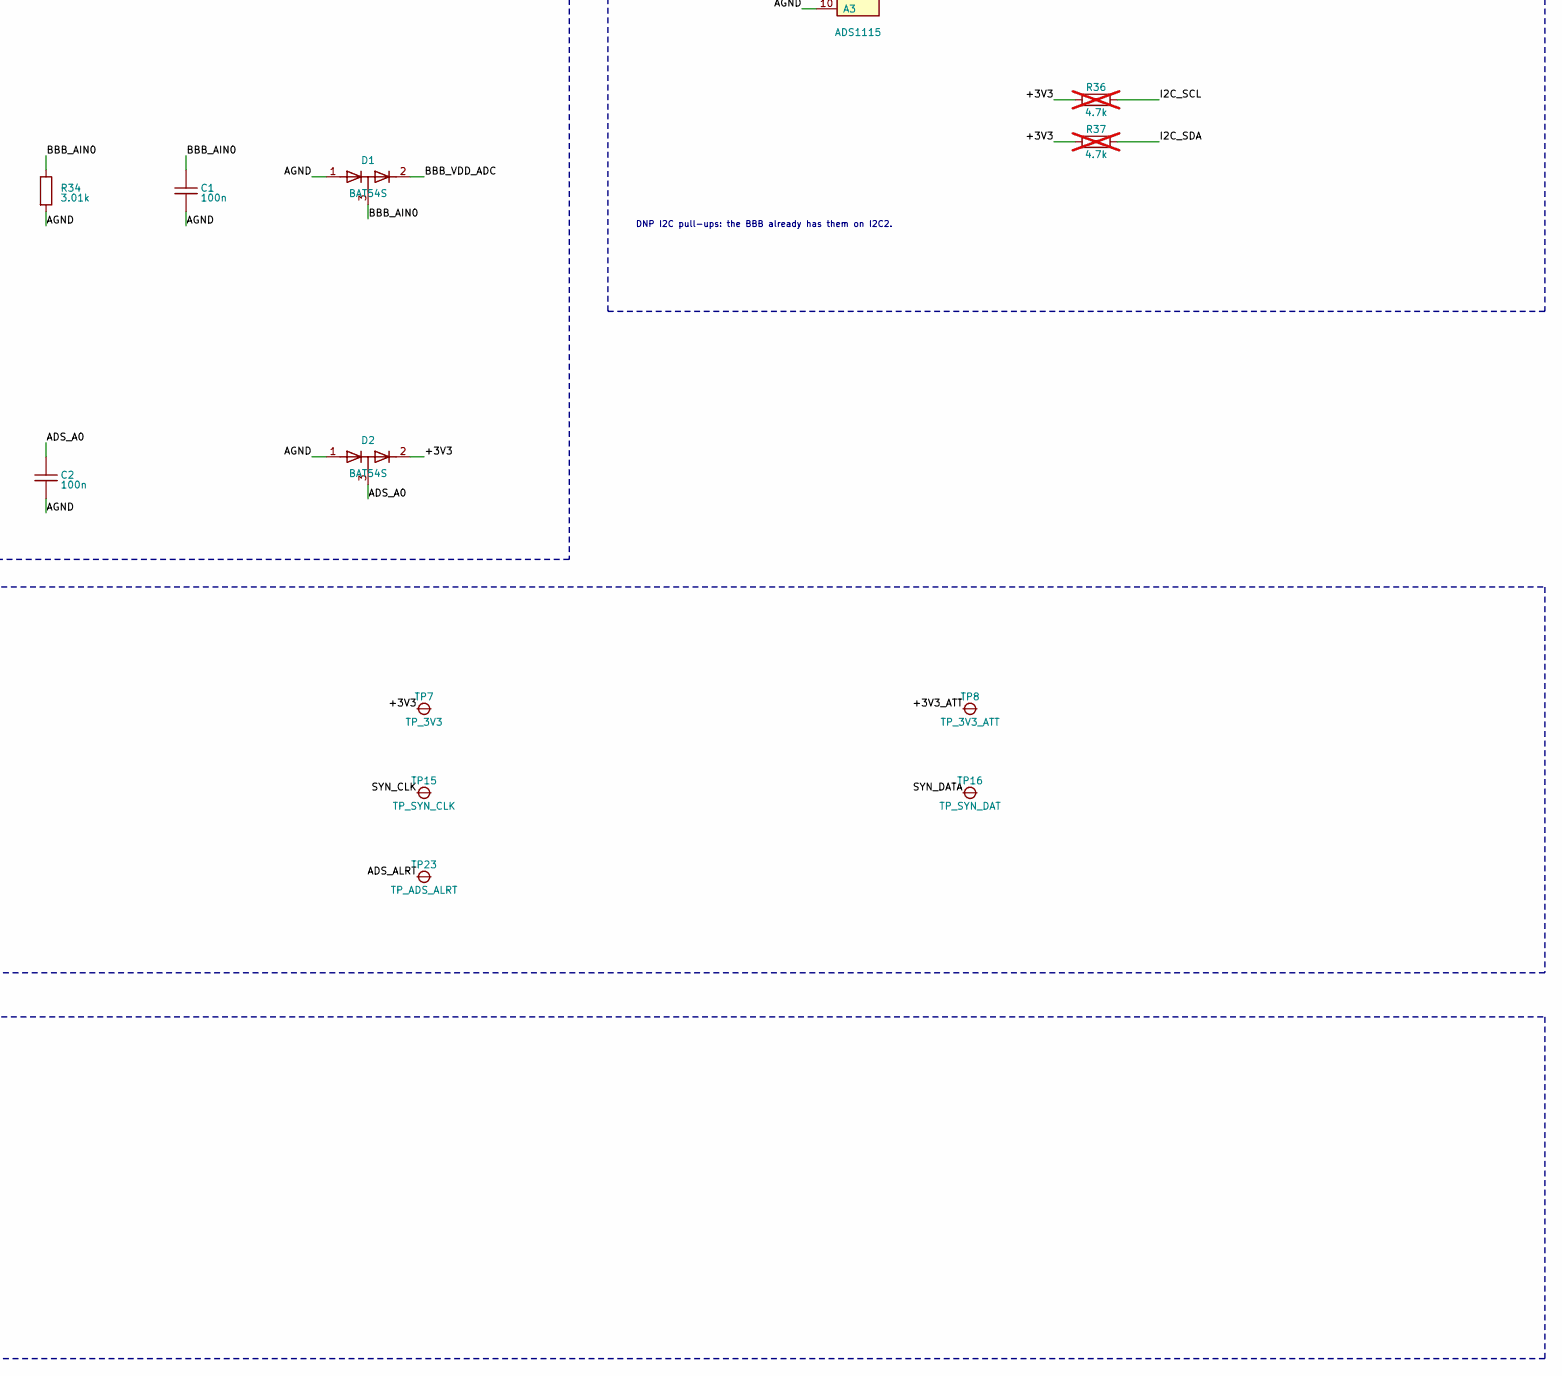
[picture p23: schematic sa_sbc_adapter.kicad_sch, SAdiy SBC adapter, part in row 2, column 3]

Parts:
C1, C2, C4, C6, C9, C10: 100n; C_0603_1608Metric
C3, C5, C7, C8: 10u; C_0805_2012Metric
D1, D2: BAT54S; SOT-23
F1: PTC 2A; Fuse_1812_4532Metric
FB1, FB2, FB3: BLM21 2A; L_0805_2012Metric
J1: BBB P9; BBB_Header_2x23_Male_Bottom
J2: BBB P8; BBB_Header_2x23_Male_Bottom
J4: PE4302 ctl; PinHeader_1x07_P2.54mm_Vertical
J5: PE4302 VDD pads; PinHeader_1x02_P2.54mm_Vertical
J6: ADF4351 hdr; PinHeader_2x05_P2.54mm_Vertical
J7: ADF4351 5V jack; PinHeader_1x02_P2.54mm_Vertical
J8: Detector OUT; PinHeader_1x02_P2.54mm_Vertical
J9: Detector VCC; PinHeader_1x02_P2.54mm_Vertical
J10: ADS1115; PinHeader_1x10_P2.54mm_Vertical
J11: 5V in; PinHeader_1x02_P2.54mm_Vertical
J12: CE select; PinHeader_1x03_P2.54mm_Vertical
JP1: 5V BBB; PinHeader_1x02_P2.54mm_Vertical
JP3: 3V3 BBB; PinHeader_1x02_P2.54mm_Vertical
JP5: PDR high; PinHeader_1x02_P2.54mm_Vertical
JP6: BBB ADC path; PinHeader_1x02_P2.54mm_Vertical
R1, R3, R5, R7, R9, R11, R13, R15, R17, R19, R21, R23, R25: 220; R_0603_1608Metric
R27, R28, R29, R30, R31, R32: 2.2k; R_0603_1608Metric
R33, R35: 1k; R_0603_1608Metric
R34: 3.01k; R_0603_1608Metric
R36, R37: 4.7k; R_0603_1608Metric; not fitted
R38: 0R star; R_0603_1608Metric
TP1: TP_GND1; TestPoint_Pad_D1.5mm
TP2: TP_GND2; TestPoint_Pad_D1.5mm
TP3: TP_AGND; TestPoint_Pad_D1.5mm
TP4: TP_5V; TestPoint_Pad_D1.5mm
TP5: TP_5V_RAIL; TestPoint_Pad_D1.5mm
TP6: TP_5V_SYN; TestPoint_Pad_D1.5mm
TP7: TP_3V3; TestPoint_Pad_D1.5mm
TP8: TP_3V3_ATT; TestPoint_Pad_D1.5mm
TP9: TP_PE_V1; TestPoint_Pad_D1.5mm
TP10: TP_PE_V2; TestPoint_Pad_D1.5mm
TP11: TP_PE_V3; TestPoint_Pad_D1.5mm
TP12: TP_PE_V4; TestPoint_Pad_D1.5mm
TP13: TP_PE_V5; TestPoint_Pad_D1.5mm
TP14: TP_PE_V6; TestPoint_Pad_D1.5mm
TP15: TP_SYN_CLK; TestPoint_Pad_D1.5mm
TP16: TP_SYN_DAT; TestPoint_Pad_D1.5mm
TP17: TP_SYN_LE; TestPoint_Pad_D1.5mm
TP18: TP_SYN_LD; TestPoint_Pad_D1.5mm
TP19: TP_SYN_MUX; TestPoint_Pad_D1.5mm
TP20: TP_DET_OUT; TestPoint_Pad_D1.5mm
TP21: TP_ADC_IN; TestPoint_Pad_D1.5mm
TP22: TP_ADS_A0; TestPoint_Pad_D1.5mm
TP23: TP_ADS_ALRT; TestPoint_Pad_D1.5mm

Connections:
+3V3: C5.1, C6.1, D2.2 (K2), FB3.1, J10.1 (VDD), J12.1, JP3.1, JP5.1, R27.1, R28.1, R29.1, R30.1, R31.1, R32.1, R36.1, R37.1, TP7.1 (1_1)
+5V: C3.1, C4.1, F1.2, FB1.1, FB2.1, JP1.1, TP5.1 (1_1)
/5V_EXT: F1.1, J11.1
/+3V3_ATT: C10.1, FB3.2, J5.1, TP8.1 (1_1)
/+5V_DET: C8.1, C9.1, FB2.2, J9.1, TP4.1 (1_1)
/+5V_SYN: C7.1, FB1.2, J7.1, TP6.1 (1_1)
/ADS_A0: C2.1, D2.3 (K1/A2), J10.7 (A0), R35.2, TP22.1 (1_1)
/ADS_ALRT: J10.6 (ALRT), TP23.1 (1_1)
/AGND: C1.2, C2.2, D1.1 (A1), D2.1 (A1), J1.34 (GNDA_ADC), J8.2, J10.8 (A1), J10.9 (A2), J10.10 (A3), R34.2, R38.1, TP3.1 (1_1)
/ATT_V1: J4.2 (V1), R11.2, R27.2, TP9.1 (1_1)
/ATT_V2: J4.3 (V2), R13.2, R28.2, TP10.1 (1_1)
/ATT_V3: J4.4 (V3), R15.2, R29.2, TP11.1 (1_1)
/ATT_V4: J4.5 (V4), R17.2, R30.2, TP12.1 (1_1)
/ATT_V5: J4.6 (V5), R19.2, R31.2, TP13.1 (1_1)
/ATT_V6: J4.7 (V6), R21.2, R32.2, TP14.1 (1_1)
/BBB_3V3: J1.3 (VDD_3V3), J1.4 (VDD_3V3), JP3.2
/BBB_5V: J1.5 (VDD_5V), J1.6 (VDD_5V), JP1.2
/BBB_AIN0: C1.1, D1.3 (K1/A2), J1.39 (AIN0), R33.2, R34.1, TP21.1 (1_1)
/BBB_ATT_V1: J2.7 (GPIO2_2), R11.1
/BBB_ATT_V2: J2.8 (GPIO2_3), R13.1
/BBB_ATT_V3: J2.9 (GPIO2_5), R15.1
/BBB_ATT_V4: J2.10 (GPIO2_4), R17.1
/BBB_ATT_V5: J2.11 (GPIO1_13), R19.1
/BBB_ATT_V6: J2.12 (GPIO1_12), R21.1
/BBB_I2C_SCL: J1.19 (I2C2_SCL), R25.1
/BBB_I2C_SDA: J1.20 (I2C2_SDA), R23.1
/BBB_SYN_CE: J1.27 (GPIO3_19), R9.1
/BBB_SYN_CLK: J1.22 (SPI0_SCLK_GPIO0_2), R1.1
/BBB_SYN_DATA: J1.18 (SPI0_D1_GPIO0_4), R3.1
/BBB_SYN_LD: J1.23 (GPIO1_17), R7.1
/BBB_SYN_LE: J1.17 (SPI0_CS0_GPIO0_5), R5.1
/BBB_VDD_ADC: D1.2 (K2), J1.32 (VDD_ADC)
/DET_DIV: JP6.2, R33.1
/DET_OUT: J8.1, JP6.1, R35.1, TP20.1 (1_1)
/I2C_SCL: J10.3 (SCL), R25.2, R36.2
/I2C_SDA: J10.4 (SDA), R23.2, R37.2
/SYN_CE: J12.3, R9.2
/SYN_CE_M: J6.3 (CE), J12.2
/SYN_CLK: J6.7 (CLK), R1.2, TP15.1 (1_1)
/SYN_DATA: J6.6 (DAT), R3.2, TP16.1 (1_1)
/SYN_LD: J6.9 (LD), R7.2, TP18.1 (1_1)
/SYN_LE: J6.5 (LE), R5.2, TP17.1 (1_1)
/SYN_MUX: J6.8 (MUX), TP19.1 (1_1)
/SYN_PDR: J6.10 (PDR), JP5.2
GND: C3.2, C4.2, C5.2, C6.2, C7.2, C8.2, C9.2, C10.2, J1.1 (GND), J1.2 (GND), J1.43 (GND), J1.44 (GND), J1.45 (GND), J1.46 (GND), J2.1 (GND), J2.2 (GND), J4.1 (GND), J5.2, J6.1 (GND), J6.4 (GND), J7.2, J9.2, J10.2 (GND), J10.5 (ADDR), J11.2, R38.2, TP1.1 (1_1), TP2.1 (1_1)

Notes on the sheet:
J6 pin 2 (board 3V3) stays open: it is the AMS1117 output. Pin order assumed from hw/netlist.md; check against the board silkscreen.
Detector and ADC front end
5V rail (+5V): JP1 fitted: BBB VDD_5V (P9.5/6) joins the rail A) external 5V on J11 powers the BBB: fit JP1, and do NOT plug the BBB's own supply B) the BBB powers the modules: fit JP1, leave J11 empty (a BBB on USB only has no VDD_5V) 3V3 rail (+3V3), from the BBB only: JP3 fitted: BBB 3V3 (P9.3/4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
ADS1115 path (A0): 1k, 100n, clamp to 3V3 and ground.
Power: external 5 V and/or SBC, 3.3 V from the SBC
SAdiy SBC adapter: BeagleBone Black cape for the module boards
ADS1115 breakout (address 0x48)
R38 joins AGND (detector return, BBB GNDA_ADC) to GND at one point.
Test points (names follow hw/test-points.md)
DNP I2C pull-ups: the BBB already has them on I2C2.
ADF4351 board (SPI + lock detect, 5 V on its DC jack)
CE: jumper 1-2 = tied high (default), 2-3 = SBC pin
J8: find which header pin is OUT with a DMM first, then match pin 1.
PE4302 attenuator (parallel control, header GND V1..V6)
Every BBB signal has a 220 ohm series resistor at the BBB header (source termination, limits fault current).
Notes for the PCB
Signal rows: BBB header - 220 ohm - module net
J7: check the polarity marking at the DC jack before connecting.
J5: red lead = VDD (3.3 V), black = GND. Measure the pads before connecting.
BeagleBone Black headers (male pins on the BOTTOM side of the PCB)
Pull-ups R27..R32: with the module's 10k pull-downs the boot default is about 2.7 V = 31.5 dB. Remove them if you want 0 dB when the SBC is off.
BBB path (AIN0, 1.8 V max): ratio 0.75, RC and clamp. Fit JP6 only for the BBB.
PLACEMENT (the SBC and the modules are on opposite sides of the board) J1, J2: BBB headers, 2x23 male pins, bodies on the BOTTOM side, long pins down into the BBB sockets. Pin 1 of P8/P9 as on the BBB. J4..J12, jumpers, test points, ferrites, caps: TOP side. Keep ~25 mm clear above the BBB Ethernet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
Ferrite beads isolate the module supplies from the SBC rails.
JP5 fitted = PDR high (RF on). Remove if the board already pulls it up.

Board: 2 copper layers, 79 parts (2 on the bottom side), 45 nets, no tracks yet.
