patrikeder/SAdiy/zynq-ebaz/rtl/scripts/gen_pinmap.py

#!/usr/bin/env python3
"""Pin map report of the EBAZ4205 design: docs/pinmap.md (table) and docs/pinmap.svg (picture).

Sources (read only):
  rtl/fpga/constraints/data2_pins.xdc   pins that are constrained in the build (= "in use")
  rtl/fpga/constraints/eth.xdc          Ethernet PHY pins (board fixed)
  pins.toml of session L                names, connector pins and notes; entries with active = false are "planned"
  rtl/fpga/ps7_config.tcl               MIO use (SD card, console UART)
  rtl/fpga/clg400_pins.csv              package table (bank, I/O name, site), from dump_package.tcl
Output: docs/pinmap.md, docs/pinmap.svg (connectors), docs/pinmap-fpga.svg (ball map of the package)
Usage: python3 gen_pinmap.py [--check]
"""
import csv
import re
import sys
import tomllib
from pathlib import Path

RTL = Path(__file__).resolve().parents[1]
EBAZ = RTL.parent
OUT_MD, OUT_SVG = EBAZ / "docs/pinmap.md", EBAZ / "docs/pinmap.svg"
OUT_BALLS = EBAZ / "docs/pinmap-fpga.svg"


def find_pins_toml():
    for p in (RTL / "vivado/pins.toml", EBAZ.parent.parent / "SAdiy-linux/zynq-ebaz/rtl/vivado/pins.toml"):
        if p.exists():
            return p
    sys.exit("pins.toml not found")


def package():
    """{ball: (bank, io function, site)} for xc7z010clg400."""
    with open(RTL / "fpga/clg400_pins.csv") as f:
        return {r["ball"]: (r["bank"], r["function"], r["site"]) for r in csv.DictReader(f)}


def used_balls():
    """{port name: ball} from the XDC files of the build."""
    d = {}
    for f in ("constraints/data2_pins.xdc", "constraints/eth.xdc"):
        for line in (RTL / "fpga" / f).read_text().splitlines():
            if line.lstrip().startswith("#"):
                continue                       # commented-out constraints are not in the build
            m = re.search(r"PACKAGE_PIN (\w+).*get_ports \{?([\w\[\]]+)\}?\]", line)
            if m:
                d[m.group(2)] = m.group(1)
    return d


FUNC = {  # signal prefix -> (function, colour)
    "adf4351": ("ADF4351 synthesiser", "#2f6fdb"),
    "pe4302": ("PE4302 attenuator", "#e07b00"),
    "i2c": ("I2C, ADS1115", "#2a9d4b"),
    "adc": ("AD9226 (planned)", "#6b6b6b"),
    "spare": ("spare", "#c8c8c8"),
}


def func_of(name):
    for k, v in FUNC.items():
        if name.startswith(k):
            return v
    return ("other", "#999")


def load():
    toml = tomllib.loads(find_pins_toml().read_text())
    used = used_balls()
    rows = []
    for s in toml["signal"]:
        port = s["name"]
        rows.append(dict(conn=s["connector"], pin=int(s["pin"]), name=port, ball=s["ball"], dir=s["dir"],
                         note=s.get("note", ""), used=port in used and used[port] == s["ball"],
                         planned=not s.get("active", False)))
    return rows


def fixed_balls():
    """Ethernet ports and their balls, from eth.xdc."""
    return sorted(((b, p) for p, b in used_balls().items() if p in ETH_PORTS or p.startswith(("ENET0", "enet0"))),
                  key=lambda t: t[0])


ETH_PORTS = set()
FIXED = [  # board-fixed functions: (group, signal, ball or MIO, note)
    ("Ethernet PHY (MII on EMIO)", "phy clk 25 MHz (FCLK1)", "U18", "out"),
    ("Ethernet PHY (MII on EMIO)", "MDC / MDIO", "W15 / Y14", "out / inout"),
    ("Ethernet PHY (MII on EMIO)", "RX_CLK, RX_DV, RX_ER", "U14, W16, G17", "in"),
    ("Ethernet PHY (MII on EMIO)", "RXD[3:0]", "Y17, V17, V16, Y16", "in"),
    ("Ethernet PHY (MII on EMIO)", "TX_CLK, TX_EN", "U15, W19", "in / out"),
    ("Ethernet PHY (MII on EMIO)", "TXD[3:0]", "Y19, V18, Y18, W18", "out"),
    ("PS MIO (fixed pins)", "SD card (TF) SD0", "MIO 40..45", "boot"),
    ("PS MIO (fixed pins)", "console UART1 (J7)", "MIO 24..25", "115200"),
]


def md(rows):
    L = ["# Pin map (generated by rtl/scripts/gen_pinmap.py, do not edit)", "",
         "Reference: EBAZ4205 (XC7Z010-CLG400), expansion connectors DATA1..3 (2.0 mm, 2x10). All I/O LVCMOS33, "
         "series 22 ohm on the board. Master list: `rtl/vivado/pins.toml` (session L). "
         "\"In use\" = constrained in the current bitstream.", "",
         "## Expansion connectors", "",
         "| Connector pin | FPGA ball | Bank | I/O name | Signal | Dir | Function | Status | EMIO / note |",
         "|---|---|---|---|---|---|---|---|---|"]
    pk = package()
    for r in sorted(rows, key=lambda r: (r["conn"], r["pin"])):
        L.append(f"| {r['conn']}-{r['pin']} | {r['ball']} | {pk[r['ball']][0]} | {pk[r['ball']][1]} | "
                 f"`{r['name']}` | {r['dir']} | {func_of(r['name'])[0]} | "
                 f"{'in use' if r['used'] else 'planned' if r['planned'] else 'NOT constrained'} | {r['note']} |")
    L += ["", "Supply / ground per the plan: pins 1-2 of every connector are supply (5..12 V, never wire to a "
          "peripheral), 3-4 and 12 GND, 10 NC. DATA3 is not mapped yet.", "",
          "## Board-fixed pins, one line each", "",
          "| FPGA ball / pin | Bank | I/O name | Signal | Group |", "|---|---|---|---|---|"]
    for ball, port in fixed_balls():
        bank, fn, _ = pk[ball]
        L.append(f"| {ball} | {bank} | {fn} | `{port}` | Ethernet PHY (MII on EMIO) |")
    for mio, what in [(24, "UART1 TX/RX (console, J7)"), (25, "UART1 TX/RX (console, J7)")] + \
            [(n, "SD0 (boot card)") for n in range(40, 46)]:
        for ball, (bank, fn, _) in pk.items():
            if fn.startswith(f"PS_MIO{mio}_"):
                L.append(f"| {ball} | {bank} | {fn} | MIO {mio} | {what} |")
    L += ["", "Bank 34 and 35 are the PL I/O banks (3.3 V here); banks 500 and 501 are the PS MIO banks. "
          "Package ball map: `pinmap-fpga.svg`.", ""]
    L += ["", "## EMIO line map (Linux GPIO line = 54 + n on the Zynq gpiochip)", "",
          "| n | Signal | n | Signal |", "|---|---|---|---|"]
    emio = ["pe4302_v[0] (V1)", "pe4302_v[1] (V2)", "pe4302_v[2] (V3)", "pe4302_v[3] (V4)", "pe4302_v[4] (V5)",
            "pe4302_v[5] (V6)", "adf4351_ce", "adf4351_ld"]
    L += [f"| {i} | {emio[i]} | {i + 8} | unused |" for i in range(8)]
    L += ["", "Also on EMIO: SPI0 (SCLK, MOSI, SS0 = LE) and I2C0 (SCL, SDA), see the table above.", ""]
    return "\n".join(L)


# ------------------------------------------------------------------ SVG
def svg(rows):
    by = {(r["conn"], r["pin"]): r for r in rows}
    W, H = 1560, 820
    o = [f'<svg xmlns="http://www.w3.org/2000/svg" viewBox="0 0 {W} {H}" font-family="Helvetica,Arial,sans-serif" '
         f'font-size="12">',
         '<title>EBAZ4205 pin map</title>',
         f'<rect width="{W}" height="{H}" fill="#fff"/>',
         '<text x="20" y="30" font-size="20" font-weight="bold">EBAZ4205 pin map (current bitstream)</text>',
         '<text x="20" y="50" fill="#555">XC7Z010-CLG400, I/O LVCMOS33, 22 ohm series on the board. '
         'Pin numbering of the 2x10 headers: row n holds pins 2n-1 | 2n (orientation not verified on the board).</text>',
         # board
         '<rect x="20" y="70" width="1120" height="730" rx="14" fill="#1f7a4d" stroke="#0f4a2d" stroke-width="3"/>',
         '<text x="580" y="98" text-anchor="middle" fill="#dff5e6" font-size="14" font-weight="bold">'
         'EBAZ4205 (top view, schematic arrangement)</text>',
         '<rect x="500" y="640" width="160" height="60" rx="6" fill="#16603b" stroke="#0f4a2d"/>',
         '<text x="580" y="665" text-anchor="middle" fill="#dff5e6">Zynq XC7Z010</text>',
         '<text x="580" y="683" text-anchor="middle" fill="#dff5e6" font-size="11">PS: SD, UART1, EMIO</text>']
    # connectors
    cols = {"DATA1": 60, "DATA2": 420, "DATA3": 780}
    top = 150
    rh = 44
    for conn, x0 in cols.items():
        o.append(f'<rect x="{x0 + 82}" y="{top - 28}" width="76" height="{rh * 10 + 20}" rx="5" fill="#222"/>')
        o.append(f'<text x="{x0 + 120}" y="{top - 36}" text-anchor="middle" fill="#fff" font-weight="bold" '
                 f'font-size="15">{conn}</text>')
        for n in range(10):
            y = top + n * rh
            for side, pin in (("L", 2 * n + 1), ("R", 2 * n + 2)):
                r = by.get((conn, pin))
                cx = x0 + 102 if side == "L" else x0 + 138
                if r:
                    col = func_of(r["name"])[1]
                    dash = ' stroke-dasharray="3 2"' if r["planned"] else ""
                    fill = "#fff" if r["planned"] else col
                    pc = col if r["planned"] else "#fff"
                else:
                    col, dash, fill, pc = "#777", "", "#d9d9d9", "#222"
                o.append(f'<circle cx="{cx}" cy="{y}" r="13" fill="{fill}" stroke="{col}" stroke-width="2"{dash}/>')
                o.append(f'<text x="{cx}" y="{y + 4}" text-anchor="middle" font-size="11" font-weight="bold" '
                         f'fill="{pc if r else "#222"}">{pin}</text>')
                if r:
                    nm = r["name"]
                    lab = f'{nm}  [{r["ball"]}]'
                    tx = x0 + 82 - 10 if side == "L" else x0 + 158 + 10
                    anchor = "end" if side == "L" else "start"
                    o.append(f'<text x="{tx}" y="{y + 4}" text-anchor="{anchor}" font-size="11" fill="#fff">'
                             f'{lab}</text>')
                else:
                    tx = x0 + 82 - 10 if side == "L" else x0 + 158 + 10
                    anchor = "end" if side == "L" else "start"
                    txt = {1: "supply", 2: "supply", 3: "GND", 4: "GND", 12: "GND", 10: "NC"}.get(pin, "-")
                    if conn == "DATA3":
                        txt = "not mapped"
                    o.append(f'<text x="{tx}" y="{y + 4}" text-anchor="{anchor}" font-size="11" '
                             f'fill="#bfe3cb">{txt}</text>')
    # legend + fixed pins panel
    px = 1180
    o.append(f'<text x="{px}" y="100" font-size="14" font-weight="bold">Legend</text>')
    y = 122
    for k, (name, col) in FUNC.items():
        planned = k in ("adc",)
        fill = "#fff" if planned else col
        d = ' stroke-dasharray="3 2"' if planned else ""
        o.append(f'<circle cx="{px + 8}" cy="{y - 4}" r="8" fill="{fill}" stroke="{col}" stroke-width="2"{d}/>')
        o.append(f'<text x="{px + 24}" y="{y}">{name}</text>')
        y += 24
    o.append(f'<circle cx="{px + 8}" cy="{y - 4}" r="8" fill="#d9d9d9" stroke="#777" stroke-width="2"/>')
    o.append(f'<text x="{px + 24}" y="{y}">supply / GND / NC / not mapped</text>')
    y += 24
    o.append(f'<text x="{px}" y="{y}" fill="#555" font-size="11">Dashed outline = in pins.toml, not constrained '
             f'yet.</text>')
    y += 44
    o.append(f'<text x="{px}" y="{y}" font-size="14" font-weight="bold">Board-fixed pins</text>')
    y += 22
    group = None
    for g, sig, ball, d in FIXED:
        if g != group:
            group = g
            o.append(f'<text x="{px}" y="{y}" font-weight="bold" fill="#333">{g}</text>')
            y += 18
        o.append(f'<text x="{px + 8}" y="{y}" font-size="11">{sig}</text>')
        o.append(f'<text x="{px + 322}" y="{y}" font-size="11" text-anchor="end" fill="#333">{ball}</text>')
        y += 17
    y += 22
    o.append(f'<text x="{px}" y="{y}" font-size="14" font-weight="bold">EMIO GPIO lines (Linux 54 + n)</text>')
    y += 20
    for n, nm in enumerate(["V1 .. V6 = pe4302_v[0..5]", "", "", "", "", "", "adf4351_ce", "adf4351_ld"]):
        if nm:
            lab = {0: "n = 0..5", 6: "n = 6", 7: "n = 7"}[n]
            o.append(f'<text x="{px + 8}" y="{y}" font-size="11">{lab}</text>')
            o.append(f'<text x="{px + 322}" y="{y}" font-size="11" text-anchor="end">{nm}</text>')
            y += 17
    o.append(f'<text x="{px + 8}" y="{y}" font-size="11">n = 8..15</text>'
             f'<text x="{px + 322}" y="{y}" font-size="11" text-anchor="end">unused</text>')
    o.append("</svg>")
    return "\n".join(o)


def ball_svg(rows):
    pk = package()
    used = used_balls()
    sig = {}                                    # ball -> (label, colour)
    for r in rows:
        if r["used"]:
            sig[r["ball"]] = (r["name"].replace("adf4351_", "adf_").replace("pe4302_v", "pe"), func_of(r["name"])[1])
    for ball, port in fixed_balls():
        sig[ball] = (port.replace("ENET0_GMII_", "").replace("enet0_mdio_mdio_io", "mdio").replace("enet0_mdio_", "")
                                .replace("enet0_", "").replace("_0", ""), "#8a4fbf")
    for ball, (bank, fn, _) in pk.items():          # PS MIO balls used for the boot card and the console
        m = re.match(r"PS_MIO(\d+)_", fn)
        if m and int(m.group(1)) in (24, 25, 40, 41, 42, 43, 44, 45):
            sig[ball] = (("UART1 " if int(m.group(1)) < 30 else "SD0 ") + m.group(1), "#8c6d00")
    planned = {r["ball"]: r["name"].replace("adf4351_", "adf_") for r in rows if r["planned"]}
    letters = sorted({b[0] for b in pk if re.fullmatch(r"[A-Z]\d+", b)})
    cw, ch, x0, y0 = 62, 44, 56, 90
    W, H = x0 + 20 * cw + 320, y0 + len(letters) * ch + 40
    o = [f'<svg xmlns="http://www.w3.org/2000/svg" viewBox="0 0 {W} {H}" font-family="Helvetica,Arial,sans-serif">',
         '<title>XC7Z010-CLG400 ball map</title>', f'<rect width="{W}" height="{H}" fill="#fff"/>',
         '<text x="20" y="28" font-size="20" font-weight="bold">XC7Z010-CLG400: balls used by the design</text>',
         '<text x="20" y="48" font-size="12" fill="#555">Top view, ball A1 at the top left. Label = signal, small text = '
         'ball and bank. Grey grid = ball exists (PL bank 34 / 35 light blue, PS banks 500/501 light yellow, '
         'power and config white).</text>']
    for c in range(1, 21):
        o.append(f'<text x="{x0 + (c - 1) * cw + cw / 2}" y="{y0 - 8}" text-anchor="middle" font-size="12" '
                 f'font-weight="bold">{c}</text>')
    for i, L in enumerate(letters):
        o.append(f'<text x="{x0 - 10}" y="{y0 + i * ch + ch / 2 + 4}" text-anchor="end" font-size="12" '
                 f'font-weight="bold">{L}</text>')
        for c in range(1, 21):
            ball = f"{L}{c}"
            x, y = x0 + (c - 1) * cw, y0 + i * ch
            if ball not in pk:
                o.append(f'<rect x="{x + 1}" y="{y + 1}" width="{cw - 2}" height="{ch - 2}" fill="#f4f4f4"/>')
                continue
            bank = pk[ball][0]
            fill = {"34": "#e3f0fb", "35": "#e3f0fb", "500": "#fdf6d8", "501": "#fdf6d8", "502": "#fdf6d8"}.get(bank,
                                                                                                           "#fff")
            stroke, txt, dash = "#bbb", "", ""
            if ball in sig:
                txt, col = sig[ball]
                fill, stroke = col, col
            elif ball in planned:
                txt, stroke, dash = planned[ball], "#6b6b6b", ' stroke-dasharray="3 2"'
            o.append(f'<rect x="{x + 1}" y="{y + 1}" width="{cw - 2}" height="{ch - 2}" rx="3" fill="{fill}" '
                     f'stroke="{stroke}" stroke-width="{2 if ball in sig or ball in planned else 1}"{dash}/>')
            tcol = "#fff" if ball in sig else "#222"
            o.append(f'<text x="{x + cw / 2}" y="{y + 17}" text-anchor="middle" font-size="11" font-weight="bold" '
                     f'fill="{tcol if ball in sig else "#222"}">{txt[:11]}</text>')
            o.append(f'<text x="{x + cw / 2}" y="{y + 33}" text-anchor="middle" font-size="9" '
                     f'fill="{"#fff" if ball in sig else "#666"}">{ball} · {bank}</text>')
    lx, ly = x0 + 20 * cw + 24, y0
    o.append(f'<text x="{lx}" y="{ly}" font-size="14" font-weight="bold">Legend</text>')
    items = [(c, n, "") for n, c in [(v[0], v[1]) for v in FUNC.values() if v[0] not in ("AD9226 (planned)", "spare")]]
    items += [("#8a4fbf", "Ethernet PHY (board)", ""), ("#8c6d00", "PS MIO: SD0 boot card, UART1 console", ""),
              ("#fff", "planned, not constrained", "d")]
    for k, (col, name, d) in enumerate(items):
        yy = ly + 24 + k * 24
        dash = ' stroke-dasharray="3 2"' if d else ""
        stroke = "#6b6b6b" if d else col
        o.append(f'<rect x="{lx}" y="{yy - 12}" width="20" height="16" rx="3" fill="{col}" stroke="{stroke}" '
                 f'stroke-width="2"/><text x="{lx + 28}" y="{yy}" font-size="12">{name}</text>')
    o.append("</svg>")
    return "\n".join(o)


def main():
    rows = load()
    files = {OUT_MD: md(rows), OUT_SVG: svg(rows), OUT_BALLS: ball_svg(rows)}
    if "--check" in sys.argv:
        bad = [p.name for p, t in files.items() if not p.exists() or p.read_text() != t]
        if bad:
            sys.exit("out of date: " + ", ".join(bad))
        print("pinmap files are current")
        return
    for p, t in files.items():
        p.write_text(t)
        print("wrote", p)


if __name__ == "__main__":
    main()
