patrikeder/SAdiy/zynq-ebaz/rtl/sim/tb_sweep.sv

// Self-checking testbench for sadiy_top through its AXI-lite interface (docs/rtl-spec.md section 10).
// Vectors (vectors/sweep_*.hex) come from the Python model, so RTL and model are checked against
// each other: the SPI words seen on the pins and the result words must be identical.
// Scenarios: refused start, taking the pins, full sweep with a lock model (two points time out),
// irq / irq_ack, stop_on_err, PS-pushed samples, abort, table write while busy, manual attenuator
// change, soft reset, pins handed back to the PS, and "no SPI word that is not in the table".
`timescale 1ns / 1ps
module tb_sweep;
  // register offsets (rtl/regmap/regmap.md)
  localparam logic [11:0] ID = 12'h000, VERSION = 12'h004, CTRL = 12'h008, STATUS = 12'h00C,
    N_ENTRIES = 12'h010, N_AVG = 12'h014, SPI_DIV = 12'h018, T_ATT_GAP = 12'h01C, T_MIN = 12'h020,
    T_STABLE = 12'h024, T_TIMEOUT = 12'h028, T_SETTLE = 12'h02C, PE4302 = 12'h030,
    PIN_STATE = 12'h034, DET_CFG = 12'h038, DET_TEST = 12'h03C, DET_PUSH = 12'h040,
    FIRST_ERR = 12'h044, POINT_COUNT = 12'h048, SWEEP_COUNT = 12'h04C, ENTRY_INDEX = 12'h050,
    TABLE_ADDR = 12'h060, TABLE_W0 = 12'h064, TABLE_W1 = 12'h068, RESULT_ADDR = 12'h070,
    RESULT_DATA = 12'h074, CAPS = 12'h078;
  localparam logic [31:0] C_START = 32'h01, C_ABORT = 32'h02, C_SRST = 32'h04, C_IRQ_EN = 32'h08,
    C_OWNER = 32'h10, C_STOP = 32'h20, C_ACK = 32'h40;
  localparam logic [31:0] S_BUSY = 32'h01, S_DONE = 32'h02, S_ERR_LOCK = 32'h04, S_ABORTED = 32'h08,
    S_WAIT = 32'h20, S_ERR_TABLE = 32'h40, S_OWNER = 32'h80;

  logic clk = 0, resetn = 0;
  always #5 clk = ~clk;

  logic [11:0] awaddr = '0, araddr = '0;
  logic [31:0] wdata = '0, rdata;
  logic awvalid = 0, wvalid = 0, bready = 0, arvalid = 0, rready = 0;
  logic awready, wready, bvalid, arready, rvalid;
  logic [1:0] bresp, rresp;
  logic irq;
  logic emio_clk = 0, emio_dat = 0, emio_le = 1;
  logic [5:0] emio_pe_o = 6'h00, emio_pe_t = 6'h3F;
  logic adf_clk, adf_dat, adf_le, ld = 0;
  logic [5:0] pe_o, pe_t;
  wire  [5:0] pe_pad = pe_t | pe_o;              // not driven = pulled up on the adapter

  sadiy_top dut (
    .clk, .resetn,
    .s_axil_awaddr(awaddr), .s_axil_awvalid(awvalid), .s_axil_awready(awready),
    .s_axil_wdata(wdata), .s_axil_wstrb(4'hF), .s_axil_wvalid(wvalid), .s_axil_wready(wready),
    .s_axil_bresp(bresp), .s_axil_bvalid(bvalid), .s_axil_bready(bready),
    .s_axil_araddr(araddr), .s_axil_arvalid(arvalid), .s_axil_arready(arready),
    .s_axil_rdata(rdata), .s_axil_rresp(rresp), .s_axil_rvalid(rvalid), .s_axil_rready(rready),
    .irq,
    .emio_adf_clk(emio_clk), .emio_adf_dat(emio_dat), .emio_adf_le(emio_le),
    .emio_pe_o, .emio_pe_t,
    .adf4351_clk(adf_clk), .adf4351_dat(adf_dat), .adf4351_le(adf_le), .adf4351_ld(ld),
    .pe4302_v_o(pe_o), .pe4302_v_t(pe_t), .pe4302_v_i(pe_pad),
    .det_ext_valid(1'b0), .det_ext_data(16'd0)
  );

  task automatic fail(input string why);
    $display("TB FAIL: %s (time %0t)", why, $time);
    $finish;
  endtask

  // ---- AXI-lite master ----
  task automatic wr(input logic [11:0] a, input logic [31:0] d);
    @(posedge clk); awaddr <= a; wdata <= d; awvalid <= 1; wvalid <= 1; bready <= 1;
    fork
      begin do @(posedge clk); while (!awready); awvalid <= 0; end
      begin do @(posedge clk); while (!wready);  wvalid  <= 0; end
    join
    while (!bvalid) @(posedge clk);
    if (bresp !== 2'b00) fail("write response not OKAY");
    @(posedge clk); bready <= 0;
  endtask

  task automatic rd(input logic [11:0] a, output logic [31:0] d);
    @(posedge clk); araddr <= a; arvalid <= 1; rready <= 1;
    do @(posedge clk); while (!arready);
    arvalid <= 0;
    while (!rvalid) @(posedge clk);
    d = rdata;
    if (rresp !== 2'b00) fail("read response not OKAY");
    @(posedge clk); rready <= 0;
  endtask

  task automatic expect_reg(input logic [11:0] a, input logic [31:0] want, input string what);
    logic [31:0] d;
    rd(a, d);
    if (d !== want) fail($sformatf("%s: read %08x, expected %08x", what, d, want));
  endtask

  task automatic expect_status(input logic [31:0] mask, input logic [31:0] want, input string what);
    logic [31:0] d;
    rd(STATUS, d);
    if ((d & mask) !== want) fail($sformatf("%s: STATUS %08x, masked %08x, expected %08x", what, d, d & mask, want));
  endtask

  task automatic wait_status(input logic [31:0] mask, input logic [31:0] want, input string what);
    logic [31:0] d;
    for (int i = 0; i < 200000; i++) begin
      rd(STATUS, d);
      if ((d & mask) === want) return;
    end
    fail({"timeout waiting for ", what});
  endtask
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
