patrikeder/SAdiy/(commit log)

2026-11-01 removed RPI connector + board updates
    [sa_sbc_adapter.kicad_pcb, sa_sbc_adapter.kicad_sch]
2026-11-05 add BBB bench mode: Pins tab, raw board access, check patterns
    Direct pin control for wiring tests, handled inside sweepd and exclusive
    with sweeping.
    - pinmap.py: one pin map for the generator, the daemon and the GUI
    - server/bench.py: bench_* commands, safety rules and safe state
    - GUI Pins tab: clickable P8/P9 with the boards, raw ADF4351, PE4302 and
    ADC access, patterns with preview and CSV export
    - ADS1115 driver, now the main ADC on the BBB too; I2C2 is P9.19/P9.20
    - GNDA_ADC (P9.34) and AIN0 (P9.39) are the optional cross-check only
    - sweepd --bench-only runs bench mode before build_hw_engine exists
    - regenerate netlist and the diagrams whose content changed
    Tested on the fake bac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
2026-11-05 rewrite README to match the current state of the repo
    Separate the planned signal chain from what is built, add running on the
    BBB, the process overview and the hardware documents, and shorten the
    status table. The adapter board is BBB only; RPi notes stay in the repo.
2026-11-06 fix deploy for bench mode on the BBB
    The service crash-looped on hardware because build_hw_engine is not
    written, so run it with --bench-only until it is.
    - add a boot-time pin mode script and service, and an example local config
    - rewrite the setup notes: missing packages, Python version, working bench
    command, root instead of a sweepd user, network safety
    - align the BBB commands in the README and docs
    - test that the script matches pinmap.py and the service keeps the flag
    Not yet run on a real BBB.
    [test_deploy.py]
2026-11-06 add BBB package builder and update script, fix GUI install on aarch64
    dist/ had no build script, and install.sh and README-BBB.md lived only
    there, so they could not be rebuilt.
    - tools/make_bbb_package.py builds the package from this checkout
    - deploy/install.sh and README-BBB.md are now tracked and updated
    - deploy/sadiy-update.sh updates an existing installation from a package:
    checks it first, keeps local.toml and cal/, keeps the previous copy and
    rolls back if the service does not come back
    - setup notes use the package for offline installs and updates
    - PyPI has no PyQt5 wheel on aarch64: skip it there and install with apt
    Tested with stubbed system commands, not yet on a real BB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
    [make_bbb_package.py, test_deploy.py]
2026-11-06 find GPIO banks by hardware address, cope without config-pin
    The BBB's Debian Trixie image (kernel 6.18) broke two assumptions.
    - sysfs GPIO bases are now 608, 512, 544, 576 for banks 0 to 3 and the chip
    labels are misleading, so bank*32+bit is not the sysfs number. hal/linux.py
    finds each bank from its register address and refuses to guess
    - the image has no config-pin: the pin mode script now says so and exits 0,
    and bench mode refuses to use bus pins as GPIO without a safe-state trip
    - add bringup.py gpio-map, a read-only check of the mapping on the board
    - close the I2C bus when the ADS1115 does not answer at bench open
    - the package name is dirty only when a packaged file differs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
    [base.py, bench.py, bench_core.py, bringup.py, fake.py, linux.py, make_bbb_package.py, pinmap.py]
2026-11-07 name the SPI device in errors and on the pin map
    - SPI errors now name the device tried and the ones present, and refused
    commands repeat the reason instead of "SPI is not available"
    - show that P9.17 (SPI0 CS0) is /dev/spidevN.0 in the netlist, the GUI's pin
    details and the BBB diagrams
    - split a note that ran off the edge of the P9 diagram
    [bench.py, linux.py, pinmap.py, test_bench.py]
2026-11-07 add device logging, per-point lock gating and flags, refresh docs and diagrams
    sweepd now says what it does: five log levels (error to trace) to stderr/journald
    (-v, -vv, -q, [log] in the config), a numbered ring served by a new `log` command
    and published on a `log` topic, repeat folding, and failed sweeps are caught,
    logged and leave the daemon up with the hardware in its safe state. Bench mode
    logs opens, closes, lease expiry, RF changes and hardware errors.
    The sweep engine waits for lock detect (one retune, then flags the point), takes
    the median of the ADC reads, and flags unlocked, overload, at-floor and outlier
    points. Flags travel in an optional fourth frame part, so protocol VERSI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
    [adc.py, bench.py, cli_client.py, log_core.py, logs.py, protocol.py]
2026-11-07 add optional image rejection: two sweeps with the LO on both sides
    The low-IF receiver shows every signal twice, the copy 2 IF (21.4 MHz) below. With
    `image_reject` on (config, `set` command, GUI checkbox "Image reject (2 sweeps)"),
    sweepd sweeps each trace twice, with the LO above and below the signal, and keeps
    the lower reading per point: a tone stays where it is, its image moves between the
    two sweeps and drops out. Two tones exactly 2 IF apart both survive.
    Points whose opposite LO is out of range (below the ADF4351 minimum, so RF under
    about 45 MHz, or above the AD831 limit) keep their image and get a new flag
    "image not suppressed"; so does a point where one side was unlocked. The me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
2026-11-07 pack ADF4351 R0..R3 and R5, add bring-up plan for 2026-11-07
    Adf4351.registers() returns the six words in write order R5..R0: INT/FRAC,
    MOD with prescaler (4/5 up to 3.6 GHz VCO, else 8/9) and phase, R2 and R3
    with integer-N settings when FRAC = 0, R5 with the LD pin as digital lock
    detect. R4 still takes the output state from the driver, so outputs stay off
    until enabled. Field positions are unit-tested; the words are not yet checked
    against ADI's evaluation software.
    tools/bringup.py pll now prints the six words for a frequency. Docs that said
    the packing was missing are updated, and docs/bringup-2026-11-07.md holds the
    day's test plan (SPI, I2C, ADF4351 lock, detector, PE4302 weights).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
    [adf4351.py, bringup.py, test_adf4351_registers.py]
2026-11-09 add Synth tab: ADF4351 LO presets and a device readback in the status bar
    New bench_synth command: plan the PLL, outputs off, write R5..R0, wait for lock
    detect, and turn the main output on only if asked and locked (own confirm every
    time, refused above the AD831's 500 MHz). Status gains "lo" (IF, injection, PFD)
    and "synth", the ADF4351 readback: the words written in the session, decoded
    (adf4351.decode_registers), plus the live LD pin; while sweeping, the LO of the
    last point. The chip itself can not be read on this wiring.
    The Synth tab lists presets derived from sweepd's status (first light, LO for the
    test tones, sweep start/center/stop, image check) and takes a custom frequency
    and po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
2026-11-14 seam: platform plugin hook, optional sweep offload, zynq-ebaz test paths
    build_hw_engine resolves [platform] name to sadiy_ebaz.platforms.<name>;
    SweepEngine takes an optional offload (run_points) and shares the per-point
    evaluation with the existing loop; pytest paths and .gitignore for zynq-ebaz.
    [sweepd.py]
2026-11-14 zynq-ebaz: PL sweep engine (F1 + F2): spec, register map, RTL, testbenches, Vivado scripts
    Spec docs/rtl-spec.md, register map and generator, engine RTL (sadiy_top,
    sweep_seq, adf4351_spi, pe4302_mbb, det_sampler, pin_mux), xsim testbenches
    with golden vectors from the Python drivers and model, sadiy_ebaz contracts
    and PL model with contract tests, Vivado project scripts (rtl/fpga) and
    helper scripts (rtl/scripts). Simulated and built (timing met at 100 MHz);
    not run on the board yet. Status in log_rtl.md.
2026-11-14 zynq-ebaz: Linux lane S1 to S3, S8 load parts: Phase 1 flow, pins, deploy
    - rtl/vivado: pins.toml + gen_xdc.py (XDC generated), board Ethernet XDC, Phase 1 Vivado
    flow (phase1.tcl, phase1_top.v, PS7 settings extracted from the working design)
    - sw/deploy: PetaLinux notes and system-user.dtsi, build script, runtime PL load via
    fpga_manager, deploy_to_board.sh (Python code goes to /opt/sadiy)
    - sw/sadiy_ebaz/devmem.py: 32-bit register access through /dev/mem (no UIO)
    - sw/tools/ebaz_baseline.sh, tests, STATUS-linux.md, log_linux.md, ebaz-bringup.md
    Vivado flow and PetaLinux image build ran; nothing tested on the board yet.
2026-11-14 zynq-ebaz: pin map report with FPGA package locations (table and SVGs)
